offgridevices/mesh-fieldlab/docs/packet-logger-design.md

# Standalone packet logger — design

**Status:** design agreed, implementation starting. Hardware not yet in hand.
**Date:** 2026-08-11

A self-contained field logger that records per-packet RSSI, SNR, hop data and node identity from a Meshtastic mesh to a microSD card, with **no phone and no laptop present at the node**. Data is retrieved afterwards by pulling the card.

Four are being built. They run unattended for a full field session.

---

## 1. What this is

A microSD packet logger for a Meshtastic node. It records the metadata of every packet the node receives — signal strength, signal-to-noise ratio, hop count, sender, packet ID — as CSV, unattended, with no phone or computer attached.

Stock tooling does not cover this. A paired phone displays signal strength live but writes nothing to disk and has to stay within Bluetooth range. The natural alternative — having the radio firmware write the file itself — does not work on this hardware, for reasons worth documenting since the official documentation currently suggests otherwise.

## 2. Why the radio cannot do this alone

Verified directly against `meshtastic/firmware` at commit `546b9d9` (2026-08-11) and `meshtastic/Meshtastic-arduino` at `v0.0.7`. If you are reading this later, re-check — these are the kind of facts that change.

### 2.1 Serial `LOG` mode is documented but not implemented

The Meshtastic docs describe serial mode `LOG` as "ideal for logging mesh activity to a data logger such as a SparkFun OpenLog", and the protobuf enum defines both `LOG = 9` and `LOGTEXT = 10`.

No handler exists. In `src/modules/SerialModule.cpp`, `handleReceived` branches on `PROTO`, `DEFAULT`/`SIMPLE`, `TEXTMSG`, `NMEA`/`CALTOPO`, `WS85` and `MS_CONFIG`. Setting a device to mode 9 or 10 produces no output at all.

**The documentation is ahead of the code.** Anyone planning around `LOG` mode should test it before building on it.

### 2.2 Range Test cannot save to file on nRF52 boards

`RangeTestModule` looks like it solves this — it has a `save` option and writes a CSV including RSSI. But in `src/modules/RangeTestModule.cpp`, the entire body of `appendFile` is wrapped in `#ifdef ARCH_ESP32`. The `#else` branch logs `Can't store range test results - ESP32 only` and returns.

The call site *is* compiled for nRF52, so on a RAK4631 the function is called on every packet and does nothing. `range_test.save` silently has no effect.

Range Test remains useful as a **traffic generator**, and is used that way here.

### 2.3 GPS and a serial logger are mutually exclusive on the RAK19003

On the RAK19003 base board, WisBlock sensor slots C and D carry `TXD1` and `RXD1` — the same UART1 that the `J7` header exposes. A UART GPS module in either slot contends with the serial logger for the same peripheral.

You can have a GPS module or a serial logger, not both. Positions are handled another way (§7).

### 2.4 What does work

`SerialModule` is compiled for nRF52 (the arch guard in `SerialModule.h` includes `ARCH_NRF52`), and `PROTO` mode exposes the full Meshtastic client API over the serial port — the same protocol the phone apps use. That is the path this design takes.

## 3. Architecture

Each node is a Meshtastic radio, a small logger microcontroller pretending to be a phone, and a memory card.

```
   [ RAK4631 + RAK19003 base ]                 [ XIAO ESP32-C6 ]
   stock Meshtastic firmware                   Meshtastic-arduino (forked)
   Serial Module = PROTO                       acts as a client, as a phone would
   whip antenna via U.FL -> SMA pigtail
                                                        |
   J7 pin 2  TX1  ------------------------->  D7 (GPIO17) RX
   J7 pin 1  RX1  <-------------------------  D6 (GPIO16) TX
   J7 pin 3  GND  --------------------------  GND   (signal return)
   J6 pin 1  VDD 3.3V --------------------->  3V3
   J6 pin 2  GND  --------------------------  GND   (power return)
                                                        |
                                                        v
                                            [ 3.3V microSD breakout ]
                                            SCK D8 / MISO D9 / MOSI D10 / CS D3

   P2  <---  one ~2000 mAh LiPo (the only battery in the node)
```

The radio runs unmodified firmware. All custom code lives on the logger board.

### 3.1 The logger must transmit, not just listen

A passive tap on the radio's transmit line does not work. The client has to talk back:

- The radio streams nothing until it receives a `want_config_id` request. Silence in, silence out.
- The library sends a heartbeat every 60 seconds. The firmware comment is explicit — it cannot detect whether a client is attached, so it infers presence from recent messages.

A receive-only wiring goes quiet after about a minute. **Both directions must be connected.**

### 3.2 Alternatives considered and rejected

| Option | Why not |
|---|---|
| Range Test `save` | ESP32-only; these boards are nRF52 (§2.2) |
| Serial `LOG` mode + OpenLog | Not implemented in firmware (§2.1) |
| Phone or laptop at each node | Not possible with nodes kilometres apart and two people |
| Raspberry Pi Zero 2 W | Chronic availability problems |
| Raspberry Pi 5 | Needs 5 V at several amps; will not run from a 3.7 V LiPo |
| XIAO nRF52840 / RP2040 / SAMD21 | Library falls back to software serial — unreliable at 38400 continuous |
| SD module with a level-shifter chip | Its regulator wants 4.5–5.5 V. There is no 5 V rail on a battery node |
| Separate LoRa sniffer per node | Measures the sniffer's link, not the node's |

## 4. The library change

The logger uses [`meshtastic/Meshtastic-arduino`](https://github.com/meshtastic/Meshtastic-arduino), which speaks the client protocol over a wire. It needs one change.

**The library decodes RSSI and SNR and then discards them.** `meshtastic_MeshPacket` carries `rx_rssi` and `rx_snr`; the library's nanopb decode populates both. But all three public callbacks — text message, portnum, encrypted — omit them from their signatures. Neither field is read anywhere in `mt_protocol.cpp`. There is no setting that changes this.

Since RSSI and SNR are the entire measurement, this is not optional.

### 4.1 The change

Add a fourth callback carrying the full packet metadata, fired at the top of `handle_mesh_packet` for **every** packet — before the portnum switch, whose `default:` branch would otherwise drop unrecognised port numbers from the log entirely.

```c
typedef struct {
  uint32_t from, to, id, rx_time;
  uint8_t  channel;
  float    rx_snr;
  int32_t  rx_rssi;
  uint8_t  hop_limit, hop_start, next_hop, relay_node;
  bool     via_mqtt, is_decoded;
  uint32_t portnum;      // valid only when is_decoded
  uint16_t payload_size;
} mt_packet_meta_t;

void set_packet_meta_callback(void (*cb)(const mt_packet_meta_t *meta));
```

Roughly 30 lines across two files. **Existing callback signatures and return values are untouched**, so the library's own examples still compile and future merges stay simple. With no callback registered the added cost is one null check per packet.

**Status: written, and pinned below.** The change also ships an example sketch and a host-side test suite that builds the library against a stub Arduino layer, so the callback can be exercised on a development machine. Twenty-eight checks cover field-by-field propagation, direct versus relayed receptions, encrypted payloads, unrecognised port numbers, and registering and unregistering the callback. Passing them says nothing about real hardware — that is what §12 is for — but it means the first bench session starts from code already known to compile and behave.

### 4.2 Delivered as a fork

The change lives in a **fork of `Meshtastic-arduino` under the `offgridevices` org**, and this repository references it pinned to an exact commit:

```ini
lib_deps = https://github.com/offgridevices/Meshtastic-arduino.git#8f17d8010a916ca1307dc9ae0da31bb4964b17d7
```

This keeps the repository's no-vendored-source rule intact — what is committed here is a reference, not somebody else's code. It also satisfies GPL-3.0's requirement that modified versions carry clear notice of change, structurally: the fork's commit history *is* the notice.

**Pin to a commit, never a branch.** A floating reference means the firmware that produced a given day's measurements can no longer be rebuilt, and reproducibility is most of the reason to work this way.

**Fork base is upstream `master` at `04af41a`**, not the `v0.0.7` tag. The tag predates a substantial May 2025 rework (upstream #42) that restructured packet handling and added the portnum and encrypted callbacks; the change described above builds directly on that structure and would be considerably more awkward against the tag. Most recent upstream source change: January 2026.

The change will be offered upstream once it has proven itself in a real multi-node field run. Upstream does merge outside contributions — the rework above came from a community pull request — so this has a reasonable chance of being accepted rather than living as a fork forever.

## 5. Hardware

### 5.1 Per node

| Item | Notes |
|---|---|
| RAK4631 Core + RAK19003 Mini base | nRF52840 MCU, SX1262 radio. Arduino bootloader, not RUI3 |
| Seeed XIAO ESP32-C6 | Needs Arduino ESP32 core 3.x or newer |
| 3.3 V microSD breakout | Bare socket. Power pin must read **3V3**, not 5 V |
| microSD card | 32 GB or smaller, **FAT32, MBR partition scheme**. On macOS that is Disk Utility → *Show All Devices* → select the **card**, not the volume → Erase → Format `MS-DOS (FAT)`, Scheme `Master Boot Record`. exFAT does not work with the Arduino SD library, and a GUID scheme often fails to mount. The card is left empty; the firmware creates its own file |
| 915 MHz whip antenna | Same model on all four within a run |
| U.FL → SMA pigtail | |
| LiPo ~2000 mAh, JST-PH 2.0 | Protected cell |
| 0.91" 128×32 OLED, SSD1306, I²C | Status display. Four-pin module; must accept 3.3 V |
| SPST slide switch, ≥1 A | Inline on the battery positive lead. Recessed or guarded |
| Momentary push button | Wakes the display. Panel-mounted, beside the switch |
| 100 µF electrolytic × 2, 0.1 µF ceramic × 2 | One pair at the logger, one at the card |
| 10 kΩ × 2 | Contingency only — MISO and CS pull-ups if mounts prove flaky |

### 5.2 Wiring

This table is the contract between the firmware and the board. The carrier
PCB that implements it lives in
[offgridevices/offgrid-hardware](https://github.com/offgridevices/offgrid-hardware/tree/main/packet-logger-carrier);
`tools/tests/test_pinmap.py` checks it against `firmware/src/config.h`, so
changing the wiring means moving all three together. Wiring by hand on
protoboard works from the same table.

| RAK19003 | Signal | XIAO ESP32-C6 | GPIO |
|---|---|---|---|
| J7 pin 2 | TX | **D7** (RX) | 17 |
| J7 pin 1 | RX | **D6** (TX) | 16 |
| J7 pin 3 | GND | GND | — |
| J6 pin 1 | VDD 3.3 V | 3V3 | — |
| J6 pin 2 | GND | GND | — |
| J7 pin 4 | BOOT | **do not connect** | — |

**Wire by the printed label, not by these pin numbers.** RAK changed which UART reaches `J7` between board revisions and did not update the datasheet: Rev B silkscreens `RX1`/`TX1`, Rev D and later silkscreen `RX0`/`TX0`. The positions and the wiring are identical — only the radio's configuration differs, which is §8.

**`J6` carries `VDD`, which is the always-on 3.3 V rail.** The switched rail is `3V3_S`, controlled by `IO2` from the Core module, and it feeds the sensor slots. Powering the logger from `VDD` means the radio's own power management cannot cut it. Worth confirming with a meter on the first board anyway.

The `RAK4630` marking on the Core module is the radio stamp soldered to it; the module as a whole is the `RAK4631`, which is the Meshtastic build to flash, and it needs the **Arduino bootloader, not RUI3**.

| microSD module | XIAO | GPIO |
|---|---|---|
| CLK *(labelled SCK on some modules)* | D8 | 19 |
| MISO | D9 | 20 |
| MOSI | D10 | 18 |
| CS | D3 | 21 |
| 3V3, GND | 3V3, GND | — |

**The module must be 3.3 V native.** Many cheap microSD breakouts carry an `AMS1117` regulator and a `74LVC125` level shifter and expect 5 V, which does not exist anywhere in this build. A module whose only power pin is labelled `3V3` and which has no regulator on it is the right kind.

| OLED (SSD1306) | XIAO | GPIO |
|---|---|---|
| SDA | D4 | 22 |
| SCL *(labelled `SCK` on some modules — it is the I²C clock, not SPI)* | D5 | 23 |
| VCC, GND | 3V3, GND | — |

**Check the power and ground order before wiring.** These modules ship as `GND VCC SCL SDA` and as `VCC GND SCL SDA`, and reversing the first two is the usual way to destroy one.

| Panel control | XIAO | GPIO |
|---|---|---|
| Momentary button, other leg to GND | D0 | 0 |
| Slide switch | *not wired to the logger* — see §5.3 | — |

**The display is on I²C, deliberately.** The C6 has exactly one hardware SPI bus and the card already owns it. Putting the display on a separate two-wire bus means a dead screen, a shorted display wire, or a display library that misbehaves cannot disturb a card write. The card's job is the only one that matters after the node is walked away from.

The button uses the internal pull-up and reads low when pressed; no external resistor.

**Do not use the XIAO's own BOOT button for this.** It is the boot-select strapping pin, so holding it while the power switch is flicked on puts the board into firmware-update mode instead of logging — a silent failure in exactly the situation the switch creates. It is also unreachable once the enclosure is sealed.

Pins after all of the above: **D1 and D2 spare.**

Cross-connect rule: each device's transmit goes to the other's receive. Getting this backwards is the most common cause of "no data".

Cover the BOOT pad with Kapton so a stray strand cannot bridge to it.

**Known quirk:** GPIO16/17 are the C6's boot-log pins. At power-up the ROM bootloader may emit characters into the radio's receive line. Harmless — the protocol framing rejects it — but if it causes instability, any GPIO can be reassigned via `Serial1.begin(baud, SERIAL_8N1, rx, tx)`.

### 5.3 Power

One battery per node, on the radio's `P2` connector. The logger, card and display all run from the radio's 3.3 V rail via `J6`.

**The switch goes in the battery's positive lead, between the cell and `P2`** — not anywhere on the logger. It cuts power to the whole node at once, which is the point: everything stops together and the log simply ends.

Three consequences worth knowing before the first field day:

- **USB overrides it.** Plugging USB into the radio powers the node whether the switch is on or off. On the bench you will forget this and conclude the switch is broken.
- **Charging needs the switch on.** With it off, the radio's charger is disconnected from the cell.
- **Power-cycling is a normal operation, not a fault.** Each boot opens a new file stamped with the date and time it started, so nothing is ever overwritten, no session is lost by turning a node off and on, and no single file grows without bound. Switch a node off on Tuesday and on again on Thursday and you get two files that say so on the outside.

Why single-supply beats a split one: only one connector ever sees a battery, so the polarity check happens once; and if power fails, everything stops together and the log simply ends — rather than the logger dying silently while the radio keeps transmitting.

The budget this was designed to, before anything was built:

| Device | Average | Peak |
|---|---|---|
| RAK4631 + base, mostly receiving | 20–35 mA | 130 mA transmit, ~1 s bursts |
| XIAO at 80 MHz, radios off | 20–35 mA | — |
| SD module, one write per 2 s | 5–15 mA | 30–100 mA, few-ms bursts |
| OLED, blanked after boot | <0.1 mA | 5–8 mA while displaying |
| **Total** | **design to 80 mA** | ~275 mA worst case |

The display is the one part that is switched off in software rather than left running. It is lit for the thirty-second boot test and for ten seconds per button press; the rest of the session it is asleep and draws microamps. Left permanently lit it would add roughly a tenth to the node's total draw for information nobody is standing there to read.

The base board's 3.3 V rail is rated 750 mA, so worst case is about a third of budget.

**Measured on unit one, 17 August 2026** — complete node, radio and logger and card and screen, bench supply at 3.9 V, receiving real mesh traffic with the screen blanked:

| | Measured |
|---|---|
| Idle, receiving, screen blanked | **39 mA** |
| Transmit bursts | ~139 mA |
| Highest seen | 169 mA |

**The node draws less than half the budget it was designed to**, which changes the battery and therefore the box. Twelve hours — an eight-hour session with the 1.5× margin §12 insists on — is about 470 mAh at this draw, call it 700 mAh once derated for real capacity and cutoff voltage. **A 1000 mAh cell covers a full field day.** The 2000 mAh cell originally specified runs roughly **thirty hours**, not the seventeen estimated above; the estimate was pessimistic about average draw, not about capacity. The enclosure can be smaller than planned.

**The peak figure is not yet trustworthy.** 169 mA was measured against a supply limited to 200 mA, and a limiter suppresses the very transmit burst the number is meant to capture — you cannot measure a peak your supply is clipping. The 39 mA average is sound; the peak must be taken again at a 500 mA limit. Two numbers are still owed here, both in ladder step 11: the true peak, and idle draw with the screen lit rather than blanked, so the cost of the display is a measurement instead of the estimate in the table above.

### 5.4 Safety

- Battery voltage must not exceed **4.3 V** — base board absolute maximum.
- **The RAK19003 battery connector is reverse-polarity versus the common hobby JST-PH pinout.** Confirm with a meter before every first connection. Label every battery.
- **Adding the switch means cutting a battery lead**, which is a fresh opportunity to get that polarity wrong on a connector that is already backwards. Cut and splice one lead at a time so the two are never both open, keep the switch in the positive leg, sleeve the joint, and meter the connector again afterwards. Never cut both leads at once — a LiPo with two bare ends is a short waiting for a workbench.
- First power-up on a **current-limited bench supply**, never a LiPo. Set 3.9 V, 200 mA limit; expect 20–60 mA — a complete node measured 39 mA. Pinned at the limit means a short; near zero means an open or reversed connection.
- **A bench supply on `P2` is a fine substitute for the cell on the bench**, and is the better way to work up to the first field day. Stay inside the battery range — **3.8–4.0 V**, never above the 4.3 V absolute maximum, and not as low as 3.3 V or the regulator drops out under load. Raise the limit to **500 mA once the radio transmits**, because 130 mA bursts against a 200 mA limit brown the node out and read as random resets. Raise it before **measuring** anything, too: a limiter clips the burst it is asked to report, so a peak read at a 200 mA setting is the limiter's number rather than the node's (§5.3).
- **Never run USB and a bench supply at the same time.** The base board charges a cell from USB, and with a supply on `P2` the charger pushes current into a source that cannot absorb it. USB alone for flashing and configuring; supply alone for powering.
- **Confirm `J6` reads 3.3 V with a meter before connecting anything downstream.** One probe, and it is the difference between a working node and three dead modules.
- **Never plug USB into the logger board while it is being fed 3.3 V from the radio.** One source at a time. Charging via the radio's USB is fine.
- **Never power the radio with no antenna attached.** Transmit power reflects into the amplifier, and the measurement is invalid anyway.

### 5.5 Mounting

**The binding dimension is 30 mm.** The base board is 30 mm wide. On a 50 mm-wide proto board that leaves room for exactly one more module beside it, and only if that module is the narrow one. That single fact chooses the board, its orientation, and therefore every opening in the enclosure.

Of the proto board sizes to hand, **7 × 5 cm turned landscape is the smallest that works**:

| Board | Verdict | Why |
|---|---|---|
| **7 × 5 cm** | **Use this** | Radio and logger sit side by side along the 70 mm edge with 22 mm to spare, and the card still has a clear 20 × 18 mm below. About half the board ends up unused, which is what makes it solderable rather than a fight |
| 6 × 4 cm | Possible | Everything lands, with roughly 1 mm to spare under the card module and nowhere at all for the decoupling parts. Saves 10 mm of box length |
| 7 × 3 cm | No | The board is exactly as wide as the radio. No margin, and the logger and card have nowhere to go but on top of each other |
| 8 × 2 cm | No | Narrower than the radio |
| 9 × 7 cm | Wasteful | Fits easily, and costs 20 mm of box length for nothing |

Layout, on the 2.54 mm grid, seen from the component side:

```
                              70 mm
    +----------------------------------------------------+
    |    [USB-C]                          [USB-C]        |  <- port wall
    |   +-----------------+  :  :      +-------------+   |
    |   |    RAK19003     |  :  :      |    XIAO     |   |
    |   |   + RAK4631     |  :  :      |  ESP32-C6   |   |
    |   |     30 x 35     |  :  :      |  21 x 17.8  |   |
    |   |  J6         J7  |  :  :      +-------------+   |  50 mm
    |   +-----------------+  :  :                        |
    |  = = = = = = = = = = = : =: = = = = = = = = = = =  |  3V3 rail  \ solder
    |  = = = = = = = = = = = : =: = = = = = = = = = = =  |  GND rail  / side
    |                        :  :      +-------------+   |
    |   [ 6-way lead pads ]  :  :      |   microSD   |   |
    |                        :  :      |   20 x 18   |   |
    |                        :  :      +----[====]---+   |
    +----------------------------------------------------+
                          13 mm channel      ^ card slot
```

- **Both USB-C ports face the same wall.** This is the only arrangement that achieves it on a 50 mm-wide board, and it is worth the effort: the enclosure then needs one bench face and one field face rather than openings scattered around it.
- **The card sits directly under the logger**, which keeps its bus 20 mm long. It is the only fast bus on the board and the only one worth optimising; everything else is slow enough not to care.
- **Power and ground run on the solder side**, as two bare wire rails across the middle of the board. Every module drops through to them rather than routing around them, which is what keeps the component side almost free of crossings. The rails pass under the radio, using space that is dead anyway.
- **A 13 mm channel** between the radio and the logger carries the serial pair, the screen pair and the button. It is the only part of the board with nothing above it, which later decides where two of the lid components can sit (§5.6).
- **Only four things are on the board**: radio, logger, card module and the decoupling parts. The screen, the button, the switch and the antenna are all panel-mounted and reach the board on flying leads.
- **The screen and button leave as one 6-way connector.** With the antenna lead unplugged that is two disconnects between a closed box and a bare board, which is what makes the lid removable rather than merely detachable.

Module footprints, from the manufacturers' own drawings:

| Part | Footprint | Mounting |
|---|---|---|
| RAK19003 + RAK4631 | 30 × 35 mm | Two 4-pin 2.54 mm headers, `J6` and `J7`, both on one edge |
| Seeed XIAO ESP32-C6 | 21 × 17.8 mm | 2 × 7 pins, rows 0.6 in apart, both on the 0.1 in grid |
| 3.3 V microSD breakout | ≈ 20 × 18 mm | 1 × 6 pins on the edge opposite the card slot |
| 0.91 in OLED, 128 × 32 | 38 × 12 mm, active area 22.4 × 5.6 mm | 4 pins; panel-mounted, not on the board |

**Two numbers to take off the real parts before committing to anything.**

- **The distance between `J6` and `J7`.** If it is a whole number of holes the radio drops straight into the board. If it is not, the radio still sits where the layout puts it but goes down on standoffs with five short wires instead of two header strips. The layout does not change either way; the assembly method does.
- **The height of the assembled radio stack.** It is the tallest thing in the node and therefore the only thing that sets the lid. Measure from the board face to the top of the antenna connector once the core is seated.

### 5.6 The enclosure

Sized off the layout above, with 3 mm of clearance around the board and the cell underneath it:

| | |
|---|---|
| Internal cavity | 76 × 56 × 32 mm |
| Box, closed | 80 × 60 × 37 mm — walls 2, floor and lid 2.5 |
| Standing on its feet | 41 mm to the top of the lid |
| With the antenna on | ≈ 140 mm overall |

**Each face does one job.** Ports on one long wall, card on the other, switch on a short wall, and the three things you look at or touch in the field on the lid. **The floor has no opening of any kind**, which is what makes the node safe to stand on damp ground.

| Face | Carries | Opening |
|---|---|---|
| Long wall A | Both USB-C ports | Two wells 14 × 8 mm, centres 38 mm apart, 23.3 mm above the floor |
| Long wall B | microSD card | Slot 18 × 8 mm with a finger scallop below it |
| Short wall A | Power switch | Pocket 22 × 14 mm recessed 3 mm; slot sized to the switch |
| Short wall B | — | Nothing. Leave it solid |
| Lid | Screen, button, antenna | Window 26 × 9 mm, hole Ø12 mm, hole Ø6.5 mm |
| Floor | Feet | None |

**Two lid positions are forced rather than chosen**, and both by what is underneath them:

- **The antenna cannot go over the radio.** There is about 4 mm of air above the radio stack and a bulkhead connector needs roughly 15 mm behind the panel. It goes over the flying-lead area instead, which has the full cavity height above it.
- **The button cannot go under the screen.** A panel button is about 10 mm deep and the gap above the card module is 10.4. It goes over the 13 mm channel, which is the only part of the lid with real room behind it.

**Water.** The lid overlaps the body so rain runs down the outside rather than into the seam, a small ledge above each port well sheds water off it, the feet lift every seam clear of standing water, and the floor is unbroken. Two printed bungs close the port wells when no cable is in them. This is **damp grass proof, not rain proof** — it is a field prototype, not an IP-rated box.

**Standing it up.** The node is meant to be **set down on the ground with the antenna vertical**. The log sheet wants height above ground recorded (§7); on the ground that number is about 40 mm, which is as valid an entry as any other. What the measurement actually depends on is that **the answer is identical on all four nodes**, since the comparison is between links within the set. The one thing to avoid is grass taller than the box, which puts the antenna inside the vegetation rather than above it and varies between sessions for no reason anybody records.

A **¼-20 threaded insert** in the floor is optional, and only worth fitting if ground level ever proves too noisy to work with. It has one consequence worth knowing before printing: the cell lies flat on the inside of the floor and covers nearly all of it, so the boss that holds the insert has to hang **below** the floor rather than rise inside it, and the feet must then grow from 4 mm to 7 so the box stands on its feet rather than on the insert. That costs 3 mm of box height. The hole is blind, stopping 2 mm short of breaking through, so the floor stays as sealed as it was.

**Printing.**

- **Print the body upside down**, floor upward. The floor is the face that has to stay watertight, and printing it as a top surface rather than as the first layer is the difference between a sealed floor and a floor with a seam in it. Supports are needed only inside the switch pocket.
- **Cut the openings last.** All three wall openings are positioned off the board stack, and the stack height depends on how the modules are mounted — plain headers put the ports at 23.3 mm above the floor, short wire links on 3 mm standoffs put them nearer 15, and in the second case the two ports no longer sit at the same height as each other. Build the board, measure where the three openings actually land, then commit the walls. Modelling the port wall as a **separate 80 × 34.5 mm plate that screws into a rebate** makes a wrong guess cost one small part rather than the whole box.
- **The headers set the box height, not the parts.** 8.5 mm of the 32 mm cavity is pin-header plastic. Direct wire links on 3 mm standoffs bring the cavity to about 26 mm and the closed box to 31, at the cost of a radio that no longer unplugs.

## 6. File format

One file per node per power cycle: `/LOG_<SHORTNAME>_<YYYYMMDD>_<HHMM>.csv`

The stamp is the node's **local** time at the moment logging started — a person holding a box of cards wants to recognise the afternoon they collected them, and no file can grow without bound because switching a node off ends it. Two boots inside the same minute, which is how a brownout loop looks, break the collision with a trailing `-2`, `-3`.

**Every timestamp inside the rows stays UTC.** People get local time on the outside of the file; machines get UTC on the inside, so no analysis ever has to reason about which side of a daylight-saving change a session landed on. The `BOOT` row records `tz` and `utcoff`, which is what lets the local-time name be turned back into UTC without anyone remembering which week the clocks changed.

**Nothing is logged until the clock is set.** The boot holds after the self-test and waits for the time, showing on screen what it is waiting for, because a file that starts before the clock cannot be lined up against the other three and the rows written in that window would be the only ones in the session with no absolute time on them. See §9.2.

**The wait is bounded, not absolute.** If the time never arrives the node logs anyway, under `/LOG_<SHORTNAME>_<BOOTCOUNT>.csv`, and the `BOOT` row records how long it waited in `clkwait`. An undated file still holds every RSSI and SNR reading and every link statistic within itself; coming home with nothing because a phone would not pair is not a trade worth making. If the clock turns up later the file is renamed in place. A boot-counter name surviving in a delivered set therefore means one specific thing: **that node waited, gave up, and never learned the time all session.** `validate-csv` reports this as `FILENAME_NO_CLOCK` rather than leaving it to be noticed.

Where the time comes from at all is §8.

```
schema_ver,uptime_ms,dev_rx_time,rx_node,tx_node,to_node,pkt_id,rx_rssi_dbm,
rx_snr_db,hop_limit,hop_start,hops_used,relay_node,next_hop,via_mqtt,portnum,
decoded,payload_size,channel,row_type,extra
```

`tools/src/fieldlab/schema.py` is the machine-readable version of this section, and `validate-csv --schema` prints the exact header the firmware must write.

| Field | Meaning |
|---|---|
| `schema_ver` | **4.** Bump on any change. v3 files stay readable — the header decides which layout a file is read under, and both are still understood |
| `uptime_ms` | Milliseconds since boot — the authoritative relative clock |
| `dev_rx_time` | Device epoch seconds — absolute clock, `0` if never set |
| `rx_node` | The logging node. Constant for the whole file |
| `tx_node` | Packet originator on `PKT` rows; the node being described on `NODE` rows |
| `to_node` | **v4.** Destination. `4294967295` is broadcast, which is what Range Test sends; a directed packet and a broadcast cost the channel differently |
| `pkt_id` | Dedupe key for flood copies |
| `rx_rssi_dbm` | Negative; closer to zero is stronger. **`0` means locally originated — filter out** |
| `rx_snr_db` | LoRa decodes to roughly −20 dB |
| `hop_limit` / `hop_start` | Remaining hops, and hops the packet started with |
| `hops_used` | Computed as `hop_start - hop_limit`. **`0` means direct reception** |
| `relay_node` / `next_hop` | Single bytes — the *last byte* of a node number, not a whole one. Routing hints, `0` if none |
| `via_mqtt` | Must be `0`; anything else means an internet gateway is polluting the data |
| `decoded` | **v4.** `1` if the payload could be decrypted. `portnum` means nothing when this is `0` — and `0` is also a legitimate portnum, so before this column the two cases were not separable |
| `portnum`, `payload_size`, `channel` | Application port, byte count, channel index |
| `row_type` | `PKT` \| `STATUS` \| `NODE` \| `BOOT` |
| `extra` | Empty on `PKT` rows. Everything a non-packet row needs to say, as `key=value` pairs joined by `;` |

### 6.1 Non-packet rows

Four kinds of row share one set of columns, because one open file on a microSD card is far more robust on an unattended node than four. The packet columns are fixed and typed; anything a `BOOT`, `STATUS` or `NODE` row needs beyond them goes in `extra`. Packet columns are written as `0` on those rows, so a reader filtering by `row_type` never has to wonder whether a value is real.

Values may not contain a comma or a semicolon. That keeps the field unquoted and readable by any CSV parser, and a stray separator is reported as an error rather than silently truncating a value.

| Row | Written | Required in `extra` |
|---|---|---|
| `BOOT` | Once at startup | `fw`, `preset`, `boot`, `lat`, `lon`, `alt`, `ant` |
| `BOOT` also carries | **v4**, required | `usepreset`, `txpwr`, `bw`, `sf`, `cr`, `chan`, `txon` — what the preset name actually stands for. A preset is only binding while `usepreset` is `1`; with it `0` the radio is on the explicit `bw`/`sf`/`cr` and the name it still reports is a leftover. `txpwr` is never implied by a preset at all, and every RSSI reading in the file is relative to it |
| `BOOT` also carries | optionally | `st_card`, `st_write`, `st_radio`, `st_pos`, `st_clock`, `st_heard`, `batt`, `disp` — what the boot self-test (§9.1) found |
| `BOOT` also carries | on a resumed file | `resume` — seconds of session already elapsed when this file was opened, because the card arrived late or was swapped (§9.4) |
| `STATUS` | Every 60 s | `rows`, `sd_ok`, `heap` |
| `STATUS` also carries | optionally | `drops` — rows formed with nowhere to write them; `recov` — the blocks that just came back, joined with `+` (§9.4) |
| `NODE` | Every 300 s, one row per known node | `name`, `lat`, `lon`, `batt`, `last_heard` |
| `NODE` also carries | **v4**, required | `chan_util`, `air_tx`, `volt`, `pos_time` — see §6.3 |
| `NODE` also carries | optionally | `snr`, `hops`, `up` — reserved. The library drops these before user code reaches them, so writing them needs a change to the pinned fork; reserving them now means that change will not need a v5 |

Adding an **optional** key does not bump the schema version: a reader that does not know it emits a warning and carries on, and every old file stays valid. Adding a column, changing a range, or adding a *required* key does.

**A reading the radio did not supply is written as an empty value**, never as a zero — `chan_util=` rather than `chan_util=0`. A channel genuinely at 0% and a radio that did not answer are different facts, and a session that quietly averaged the second into the first would report a quiet channel it never measured. The firmware writes empty wherever the library hands back NaN, which is what a node report with no device-metrics block produces — ordinary for a neighbour heard once in passing.

### 6.3 What the `NODE` row measures

`chan_util` is the reason these rows are worth their space.

Signal strength answers whether a link exists. It cannot answer what the link *cost*, because a channel that is idle and a channel that is saturated produce identical RSSI. `chan_util` is the radio's own estimate of the fraction of wall-clock time the channel was busy — including every other transmitter on the frequency, which no record of our own traffic could ever see. `air_tx` is this node's own share of the last hour.

Two things follow for anyone reading a session:

- **Utilisation is a property of a place, not of a node.** It is recorded against the node that *reported* it. The rows a node writes about its neighbours repeat what those neighbours last advertised, which is a different measurement taken somewhere else, and counting them would average away exactly the differences between positions that the session exists to find.
- **Above roughly a quarter of the channel the measurement changes meaning.** Meshtastic holds back non-critical traffic once utilisation is high, so past that point a session measures the radio's own governor rather than the path. `analyze-logs` warns when peak utilisation crosses 25%.

`volt` is a truer battery state than the percentage beside it, and `pos_time` is when the coordinate on the row was actually fixed — a stale position and a fresh one are otherwise the same six decimal places.

### 6.2 The checker

**This format is the contract between the logger and the analysis tooling**, so its checker was written before the firmware. `validate-csv` separates two kinds of problem.

An **error** means the file cannot be trusted: a wrong header, an impossible value, a hop count that contradicts itself, a node apparently receiving its own transmission, packets that arrived over MQTT rather than the air, a fixed position left at 0,0. Analysing a file with errors produces numbers that look reasonable and mean nothing.

A **warning** means the file is readable but something is worth knowing: a truncated last row where the node lost power mid-write, a gap where the status heartbeat stopped, a link with too few packets to take a median from.

The checker also re-reports whatever the boot self-test found, so a file can be judged weeks later without anyone having to remember what the screen said in the field.

Run it on the card before leaving the site:

```bash
uv run validate-csv /Volumes/LOGGER/ --min-packets 100
```

`synth-log` writes schema-valid files with invented numbers, so the analysis tooling can be built and tested before there is hardware to record anything real.

## 7. Position and time without GPS

A GPS module cannot coexist with the logger (§2.3), and is not needed.

**Position is set from a phone, on site, at the moment the node is placed.** Everything else about a node is configured once on a bench and never touched again; position is the one setting that cannot be, because it is not known until somebody is standing where the node will sit. Requiring a laptop for it would mean carrying one to every drop point.

So the deployment step is: connect the Meshtastic app over Bluetooth, open the position settings, **enter the coordinate and switch fixed position on**, disconnect, walk away. The logger reads the result back off the radio and shows it, which is what makes the phone enough.

```bash
# The same thing over USB, for a bench node or to check what the phone wrote.
meshtastic --port <PORT> --setlat <LAT> --setlon <LON> --setalt <ALT> \
  --set position.fixed_position true
```

**`fixed_position` does not create a coordinate. It freezes the one the node already has.** A node that has never held a position has nothing to freeze, so the switch does nothing at all — while the app shows it on, which is the trap. The order is therefore not optional:

1. **Fixed position OFF.** A node that already considers itself fixed may ignore what the phone sends it.
2. **Let the phone share its location with the node,** and wait for a send to actually happen. The share interval is a setting; shortening it to fifteen seconds is worth doing before a deployment day, because the default leaves somebody standing in a field waiting for a minute with no indication of why.
3. **Confirm the node now holds a position** — it appears on the app's map.
4. **Fixed position ON.** This is the step that makes it permanent, and it can only work now.
5. **Confirm on the logger's screen** that the position block is filled before walking away.

Step 5 is the one that matters, because it is the only check that reads the radio rather than the phone. A node with the flag set and no coordinate behind it joins the mesh, relays traffic, looks entirely healthy from the app, and records a whole session of rows that can never be tied to a place. The logger therefore treats position as set only when a coordinate is actually there (§9.1) — the flag alone is not evidence, and was believed for most of one bench session precisely because it looks like it is.

Record the intended position as well as the one actually used — the difference between them matters when interpreting the results.

**Position flags** control which fields ride along in a transmitted position. Most of them — satellites in view, heading, speed, dilution of precision, geoidal separation — come from a GPS receiver, and there is none here, so they carry nothing. Altitude is the one that earns its place. Whatever is chosen, **set all four nodes identically**: the cost of a stray flag is not airtime, it is another axis on which one node can quietly differ from the other three.

**Altitude.** Do not take altitude from GPS. Consumer GPS vertical accuracy is ±10–20 m, roughly twice as bad as horizontal. Instead:

```
node altitude = ground elevation at (lat, lon) from a 1 m DEM
              + height above ground, measured with a tape
```

Both terms are more accurate than any GPS module you could attach. This makes **measured height above ground a required field** on the field log sheet.

**Time.** The logger has no clock of its own. The XIAO has no battery-backed RTC, so every cold boot starts knowing nothing, and the only automatic source of real time is the radio — which stamps received packets with `rx_time`, and only knows the time itself if something told it.

That makes the chain worth stating plainly, because every link can break:

| Step | What supplies it | What happens if it is missing |
|---|---|---|
| Something knows the time | A GPS on any node, or a laptop running the Meshtastic CLI | **Nothing on the mesh has a clock, ever** |
| The radio learns it | CLI on connect, or another node propagating it over the mesh | That node's rows have `dev_rx_time = 0` |
| The logger learns it | `rx_time` on the first packet it receives | The file keeps its boot-counter name |

The practical consequence: **a full power-down loses the time.** The nRF52840 in the radio has no battery-backed clock either, so a node switched off on Tuesday and switched on again on Thursday starts with no idea what day it is, and stays that way until a packet arrives from something that does know.

Two ways to close that, and they are not equivalent:

- **Give one node a GPS.** It reacquires time by itself on every power-up and seeds the whole mesh. This is the only option that survives an unattended power cycle in a field with no laptop present, which is exactly the workflow the logger is built for.
- **Push the clock from the CLI before each deployment.** Connecting all four nodes to one laptop in one session gives every node correct absolute time and costs nothing extra. It has to be redone after every full power-down.

Until one of those happens the logger still records everything — `uptime_ms` is unaffected, RSSI and SNR are unaffected, and per-link statistics within a single file are unaffected. What is lost is the ability to line one node's file up against another's, and the ability to date the file.

This is **unverified** and must be tested on the bench. If it does not hold, fall back to `uptime_ms` plus a manually recorded start time — sufficient here, because the analysis computes session medians rather than time-of-flight.

## 8. Radio configuration

Identical on all four nodes except name and position.

### 8.1 The firmware version, pinned

**All four radios run Meshtastic `v2.7.26` (`54e0d8d`), the `rak4631` build with the Arduino bootloader.**

The version is pinned for the same reason the library and the build platform are: a run has to be able to be repeated on the same instrument. Different firmware between nodes is one of those faults that produces perfectly plausible data nobody can legitimately compare, and produces it silently — there is no error, only four sets of numbers that were never measured the same way.

Do not assume the version in the box is the version you want. Unit one arrived running **2.6.11, and running a vendor variant image** (`rak4631_nomadstar_meteor_pro`) rather than the vanilla `rak4631` build. It joined the mesh, relayed traffic and looked entirely normal. Flash all four to the pinned image rather than trusting what shipped.

Three things about the flashing itself:

- **The UF2 must match the board.** The RAK4631 is an nRF52840; the RAK11310 is an RP2040 — a different processor on a similarly named WisBlock core, listed beside it on the same download page. A mismatched UF2 is not refused loudly. The bootloader silently declines it and **leaves the file sitting on the mass-storage volume**, which looks exactly like a drag-and-drop that did not take, and invites people to try again with the same wrong file. Check the filename says `rak4631` before copying it — and better, check the image rather than its name. The filename is a label; the family ID inside every block is what the bootloader actually matches on. `firmware/radio/check_uf2.py` reads it: a RAK4631 image reports `0xADA52840` and loads at `0x00026000`, a RAK11310 image reports `0xE48BFF56` and loads at `0x10000000`.
- **There is more than one image called `rak4631`.** The nrf52840 release zip contains four: the plain build, `_eink`, `_eth_gw` and `_nomadstar_meteor_pro`. Only the plain one is pinned, and a variant flashes and boots perfectly, so nothing afterwards will tell you which one went on. The cache in `firmware/radio/` holds the pinned image and nothing else, so there is nothing to pick wrongly from.
- **If the board is labelled `RAK4631-R` it ships with RUI3**, not the Arduino bootloader, and must be converted first. The Meshtastic starter kits ship with the Arduino bootloader already.
- **Let the node generate a fresh key.** Meshtastic advisory [GHSA-gq7v-jr8c-mfr7](https://github.com/meshtastic/firmware/security/advisories/GHSA-gq7v-jr8c-mfr7): some vendors built device images by flashing one unit, letting it generate its keys at first boot, and cloning that image across a production batch — shipping identical X25519 keypairs on whole batches of hardware. 2.6.11 onwards warns when it recognises a compromised key, and defers key generation until the LoRa region is first set. This cannot affect the measurements, because broadcast traffic on a shared channel is protected by the channel PSK rather than by per-node keys; it matters because a node holding a cloned key can be impersonated by anyone else holding the same batch image.

### 8.2 The settings

```bash
meshtastic --port <PORT> \
  --set serial.enabled true \
  --set serial.mode PROTO \
  --set serial.txd 20 --set serial.rxd 19 \
  --set serial.baud BAUD_38400 \
  --set position.gps_mode NOT_PRESENT \
  --set lora.region US --set lora.modem_preset LONG_FAST \
  --set device.role CLIENT --set lora.hop_limit 3
```

Notes that will cost you an afternoon if missed:

- **Baud must be set explicitly on both sides.** The firmware default is 38400; the Arduino library's own default is 9600. A mismatch produces silent garbage.
- `override_console_serial_port` is valid **only** with NMEA and CALTOPO. With PROTO it produces a config error and the module will not start. Leave it false.
- `NOT_PRESENT` matters because the same UART routes to sensor slots C and D.
- **The pin numbers depend on the base board revision, and the revision is printed on the board.** RAK moved the UART that reaches `J7` at Rev D: Rev B exposes UART1 there, Rev D and later expose UART0. The wiring is identical; only these two numbers change.

  | RAK19003 revision | `J7` silkscreen | `serial.rxd` | `serial.txd` |
  |---|---|---|---|
  | Rev B | `RX1` / `TX1` | 15 | 16 |
  | **Rev D, Rev E** | `RX0` / `TX0` | **19** | **20** |

  The command above is set for **Rev E**. This was previously an open item to be resolved by trial; it is resolved by reading the silkscreen. Confirmed against the RAKwireless forum thread on the Rev E schematic change, Meshtastic issue #2267, and Meshtastic's own serial-module documentation, which gives 20/19 for "RAK19003 v2 variants" and 16/15 for the RAK19007.
- Keep the modem preset identical across all nodes and all runs. Changing spreading factor mid-experiment invalidates every comparison.

### 8.3 Two ways the tool reports failure on something that worked

Both of these were hit while configuring unit one, and one of them produced a wrong conclusion that survived several minutes and a repeated write. `configure_node.py` has to avoid both; anybody configuring a node by hand needs to know them.

**Setting a value and reading it back in the same invocation crashes the tool.** A command of the form `meshtastic --set-owner N1 --info` applies the change and then aborts *while printing the result*, with `Object of type bytes is not JSON serializable`. The exit status is non-zero and no configuration is printed, so it reads as a write that failed. It did not fail — the setting is on the radio. This is the worse of the two traps, because the natural response to an apparent failure is to run the command again. **Set and read in separate invocations, always.**

**An immediate readback returns the old value.** The write is applied and echoed back asynchronously, so an `--info` run seconds later can still report the previous setting. Reading twice does not help; it returns the stale value twice, which is convincing. On unit one a rename that had worked the first time was declared broken on exactly this evidence and repeated unnecessarily.

The rule that covers both: **a configuration step is not verified until a fresh, separate connection reports the new value.** Not the same command, not immediately, not the value the tool echoed as it wrote — a new connection, afterwards. Everything §12 says about reading configuration back depends on this being done properly, because a readback nobody trusts is no better than no readback at all.

### 8.4 Keeping the record

Save `meshtastic --info` for every node alongside the logs. Config drift between nodes is the most common invisible way to ruin a test.

**Redact it first.** `--info` prints the node's PKI **private key** in its `security` block, and its fixed position with it. A private key in a public repository lets anyone impersonate that node on the mesh, and publishing one cannot be undone — a rotation on every affected node is the only remedy. Strip the `security` block and commit the result as `config/<node>.redacted.json`; `.gitignore` is set so the raw dump cannot be added by accident. This is what `configure_node.py` will write, so the redaction is not left to whoever is holding the laptop that day.

### 8.5 Keeping a test mesh to itself

A controlled test of a fixed set of nodes — two endpoints too far apart to reach each other, two more placed between them to bridge the gap — only measures what it claims to if the set is actually closed. Every node outside the set that joins in is a change to the topology, made by somebody else, that the data records only ambiguously.

**A private channel does not close the set.** This is the trap, and it is worth stating plainly because the setting is named in a way that invites the opposite conclusion. Meshtastic separates the *radio mesh* — everyone sharing a frequency, bandwidth and spreading factor — from *channels*, which are a name and an encryption key layered on top. The channel decides who can **read** a packet. It does not decide who **hears** it, and it does not decide who **relays** it. From the project's own documentation: nodes *"rebroadcast all packets if they share LoRa modem settings, irrespective of encryption"*, and *"all nodes in the radio mesh receive messages."*

So a fresh 256-bit key buys payload privacy and nothing else. Strangers still hear every packet, still rebroadcast them, and still appear in this logger's files — correctly, because their signal readings are real measurements. For a controlled run the relaying is the damaging part: a stranger carrying one of your packets extends your topology by a node you did not place, cannot locate, and may not see again.

**What closes the set is the frequency slot.** Two nodes on different slots are on different frequencies and cannot hear each other at all. The relevant firmware arithmetic, for the US region at a 250 kHz bandwidth:

```
numChannels = floor((freqEnd - freqStart) / (spacing + bandwidth))
            = floor((928.0 - 902.0) / 0.25)                 = 104 slots

freq        = freqStart + bandwidth/2 + (slot - 1) x bandwidth
            = 902.125 MHz + 0.25 x (slot - 1)
```

`lora.channel_num` selects the slot, numbered 1 to 104, and is the setting that matters. Left at its default of `0` the radio falls back to hashing the **primary channel's name** to pick a slot — which is why changing a channel name silently moves a node to a different frequency, and why two nodes with different channel names may not reach each other however carefully their keys match. Set the slot explicitly and the name becomes cosmetic.

The public default, `LongFast`, hashes to **slot 20 — 906.875 MHz**, and that is where essentially all local traffic sits. Any slot well away from it is a candidate; the arithmetic above converts a slot number to the frequency it will actually transmit on, which is the number to check against local band use before committing to it.

**Settings, in addition to §8.2, applied identically to every node in the set:**

| Setting | Value | What it does |
|---|---|---|
| `lora.channel_num` | a chosen slot, **not** 0 | Puts the set on its own frequency. This is the one that provides isolation |
| primary channel PSK | `random`, then shared to the others | Payload privacy. Does **not** isolate — set it because there is no reason not to, not because it does the job above |
| primary channel name | anything, matched across the set | Cosmetic once the slot is explicit, but keep it consistent so nobody is misled |
| `device.rebroadcast_mode` | `LOCAL_ONLY` | Stops **our** nodes carrying foreign traffic. It cannot stop foreign nodes carrying ours — only the slot does that |
| `lora.hop_limit` | `3` | Permits up to three relays. A two-relay bridge needs two, so this leaves one spare. Identical everywhere, or hop counts are not comparable |

`lora.ignore_incoming` looks like it belongs on this list and does not: it is a blocklist of specific node numbers, capped at three entries, and deprecated in the client apps. It cannot express "everyone except these four."

**Proving a slot is empty is a job for this logger.** Set one node to the candidate slot, leave it running for half an hour, and read the card. A file containing nothing but this node's own status rows is the evidence that the slot is clear; any foreign node in it means picking another. This is a better test than reasoning about which slots ought to be busy, and it costs one session.

**Two consequences to expect, neither of them faults.** A node brought up alone on a private slot will report `ALONE` at the end of its self-test until a second node transmits, because there is genuinely nothing else there. And the boot clock wait has no mesh to take a time from, so bring the set up together, or hand a time to one node from a phone and let it propagate.

**Interference is a separate experiment, not a contaminant in this one.** Measuring how the set behaves amid uncontrolled traffic is a real question and a different one. It is answered by re-running the same physical layout on the public slot and comparing against the isolated baseline — which requires the baseline to exist first, and to be clean. Uncontrolled traffic mixed into the controlled run yields neither number.

## 9. Firmware behaviour

```
setup()
  init display; if it does not answer, carry on regardless — see below
  read and increment boot counter in NVS
  run the boot self-test (§9.1), showing each result as it lands
  if the clock is not set, hold and wait for it (§9.2), up to CLOCK_WAIT_MS
  open /LOG_<SHORTNAME>_<YYYYMMDD>_<HHMM>.csv, write header and BOOT row
    (or /LOG_<SHORTNAME>_<BOOTCOUNT>.csv if the wait timed out, renamed later)
  init serial to the radio at 38400, register the packet-metadata callback
  request node report

loop()
  service the protocol (handles want_config and the 60 s heartbeat)
  on each packet: append one row, compute hops_used, increment counters
  flush every 5 s or 10 rows, whichever comes first
  re-attempt whatever is currently broken (§9.4)
  every 60 s: STATUS row
  every 300 s: refresh node report
  on button press: wake the display 10 s, or step one page deeper (§9.3)
  LED: slow blink healthy | double-blink packet logged recently | fast continuous SD failure
```

### 9.1 The boot self-test

The node is switched on, watched for half a minute, and walked away from. That half minute is the only chance to notice a problem before it costs a session, so the test answers the questions that are expensive to get wrong — not merely "did it start".

Each line appears as its check completes, so a hang is visible at the step that hung.

| Check | What it proves | Failure means |
|---|---|---|
| Card mounts | The socket and wiring work | Reseat the card |
| **A row is written, flushed, and read back** | The card actually accepts data | A card that mounts but cannot write is the worst failure mode there is — it looks healthy for hours |
| Free space, and hours it will hold | The session fits | Swap the card |
| Radio answers on the serial link | Wiring, baud rate and PROTO mode are all correct at once | See §8; this is the single most common setup failure |
| Region, preset, hop limit | This node matches the others | Config drift silently invalidates every comparison |
| Fixed position set, and its value | The rows can be tied to a place | A node logging from 0,0 measures nothing usable |
| Clock set | Rows can be lined up against the other nodes | Fall back to recording the start time by hand |
| Battery voltage, estimated hours | The node outlives the session | Swap the cell |
| **Which other nodes were heard in 30 s, and how strongly** | This node is actually in range | A link that is dead at drop-off is dead all day |

Then `READY`, the filename, and the display blanks.

**The last check only works for nodes placed after the first.** Node 1 hears nothing at its own drop-off because nothing else is on yet. Turn nodes on in placement order and walk back past the earlier ones, pressing the button to confirm they picked up their neighbours.

**A failed check does not stop the node.** It is shown, recorded in the `BOOT` row, and logging starts anyway. A node logging with a bad clock is worth far more than a node refusing to start; the analysis can be told about a known-bad field, but it cannot invent data that was never captured.

**The display is optional at runtime.** If it does not answer at startup the firmware notes it and carries on — a failed screen must never cost a session. The LED remains the running indicator regardless.

Non-negotiable for unattended use:

- **Flush often.** A field day that dies with forty minutes buffered in RAM is a wasted field day.
- **Date and time in the filename**, so a brownout-and-reboot creates a new file instead of overwriting the old one, and so a card full of sessions sorts itself. The boot counter still backs it up when the clock is unset, and still breaks ties inside a single minute.
- **On card failure, keep running.** Keep counting, signal on the LED, retry the mount. Do not halt — a node that stops logging is worse than one that logs a gap.
- **Nothing the self-test can do may be a one-time-only ability.** Every check it makes has to be re-makeable while the node runs (§9.4).

Power management: CPU at 80 MHz, both 2.4 GHz radios out of the picture. **No deep sleep** — the logger must continuously service the serial stream.

**The 2.4 GHz radios are absent, not idle.** The logger reaches the mesh radio over a serial pair and the card over SPI; WiFi and BLE take no part in any of it, and the module’s own ceramic antenna is left doing nothing. Neither was ever started — but "off because nothing asked" is a property of today’s code rather than a guarantee, and the first symptom of a library quietly bringing one up would be a current draw that no longer matches the battery arithmetic. The two are therefore held off in different ways, for a measured reason:

| | How it is kept off | Cost |
|---|---|---|
| **BLE** | `esp_bt_mem_release()` at boot, which is irreversible for the rest of the boot — nothing can start BLE afterwards | 6 bytes of flash |
| **WiFi** | Not touched in code at all. `check_radios.py` runs after every build and fails it if a WiFi or BLE entry point is linked into the image | none |

The asymmetry is deliberate. WiFi has no one-way release, and the only way to ask it to stop is to call into the WiFi stack — which links the whole stack in. Measured on this firmware, `esp_wifi_stop()` plus `esp_wifi_deinit()` cost **133 KB of flash and 16 KB of RAM** to switch off something that was never on, putting the entire radio stack inside the image in order to announce that the radio is unused. Checking the finished binary instead costs nothing and is the stronger claim: a radio whose start function is not present cannot be started. The check is proven by injecting a real `esp_wifi_stop()` call and confirming the build fails.

Per-node settings live in `firmware/src/config.h`: short name, pins, baud, flush thresholds, timings. It is the only file that differs between the four units — change the name, flash, label the box.

**Build with the `pioarduino` platform, not `espressif32`.** The official PlatformIO ESP32 platform still ships Arduino core 2.x, which has no ESP32-C6 support at all and fails outright with *"This board doesn't support arduino framework!"*. The community fork carries Arduino core 3.x and is what every C6 board needs today. It is pinned in `platformio.ini` for the same reason the library is.

The `BOOT` row records the self-test outcome alongside the configuration, so a file can be judged later without anyone having to remember what the screen said at the time.

### 9.2 Waiting for the clock

After the self-test, a node with no time **stops and waits before it logs anything.** The screen says what it wants:

```
N1 waiting for time
CONNECT YOUR PHONE
hold button to skip
logs anyway in 8:42
```

The LED blinks throughout, because a still screen and a dark LED for several minutes is indistinguishable from a node that has crashed.

**Holding the button for two seconds skips the wait** and logs undated. This is for the bench, where there is no mesh to hand over a time and sitting through the full timeout to test something else wastes ten minutes. It must be held rather than pressed, so that a knock in a bag cannot quietly cost a session its timestamps.

A node whose radio never answered skips the wait automatically — there is no point waiting for a time to arrive down a link that is not there. That is also what makes a bench test with no radio attached start immediately instead of hanging.

The deployment ritual this is built around: **switch a node on, connect your phone to any node on the mesh, walk away.** The phone hands its clock to the radio it connects to, that radio passes the time on to its neighbours, and each logger picks it up from the first packet it hears. The wait normally ends within seconds of the phone connecting, so its usual cost is nothing.

This is why the ritual matters: **a full power-down loses the time everywhere at once.** Neither the logger nor the radio has a battery-backed clock, so four nodes switched off on Tuesday and on again on Thursday all wake up blank together, with nobody left on the mesh to ask. Something outside the mesh has to reintroduce the time, and the phone in your pocket is the cheapest thing that can.

`CLOCK_WAIT_MS` in `config.h` sets the give-up bound — ten minutes by default, far longer than pairing a phone takes and short enough that nobody sits through it by accident. Set it to `0` to restore the older behaviour of logging immediately regardless, or to something enormous to refuse to log at all without a clock.

### 9.3 The menu

The summary page carries five state blocks in a fixed order — **C R P K H** — and the button walks through them in exactly that order, one page each. The menu is the home screen read one block at a time, not a second thing to learn.

| Press | Page | Block | Answers |
|---|---|---|---|
| — | Summary | all five | Can I walk away? |
| 1 | Card | **C** | Is it recording, and will the card last? |
| 2 | Radio | **R** | Is it set up like the other three? |
| 3 | Position | **P** | Can these rows be tied to a place? |
| 4 | Clock | **K** | Can this file be lined up against the others? |
| 5 | Heard | **H** | Who can it hear, and how well? |
| 6 | Power | *(battery)* | How much is left, and how busy has it been? |
| 7 | back to Summary | | |

Every detail page opens with **the same block, drawn by the same code as the summary row** — solid for passing, hollow with a slash for failing — in the top-left corner, ahead of the title:

```
[C] CARD                 1871 MB
--------------------------------
/LOG_N1_20260817_1432.csv
5218 rows written
```

Read left to right, that is the order the question is actually asked: which check this is, what it is called, and how it is doing. The block leads because it is the thing that was wrong on the summary row — you pressed through to find out about that mark, so it is what the page opens with. You press `P` because it looked wrong on the home screen, and the page you land on is still showing you `P`, still wrong, with the reason underneath.

Page 6 is the catch-all for everything with no block of its own: battery, uptime, packets heard and how long ago the last one was. The battery shape stands in the icon's place there, so the run of pages keeps its rhythm.

The first press wakes the screen wherever it was left rather than jumping home, so a second visit to the same node opens on what you were looking at last time.

### 9.4 Recovering without a power cycle

The self-test answers five questions once, while somebody is stood there. Every one of those answers can change afterwards — and the only way to act on a changed answer used to be to open the box and cycle the power, which throws away everything recorded so far. That trade is never worth making, so the running loop re-attempts each check on a timer.

The rule: **nothing the self-test can do may be a one-time-only ability.**

| Block | The fault that can clear | What the loop does about it |
|---|---|---|
| **C** Card | No card at switch-on; a card reseated, swapped, or that failed a write | Re-mount and re-prove writability, backing off 5 s → 30 s. Resumes the session's own file if it is still there; opens a new one, with its own `BOOT` row, if it is not |
| **R** Radio | Still booting; reset, brownout, connector shaken loose | Any word from the radio counts as proof of life. At 6 minutes of silence it is asked directly every 30 s; at 12 minutes it is treated as gone, and asked every 3 s until it answers |
| **P** Position | A coordinate set from a phone part-way through a session | Settings are re-read continuously; while no position is set the radio is also asked directly, every 60 s |
| **K** Clock | The first packet carrying a time arrives | Already recovered on its own; the file renames itself from its boot counter to its date |
| **H** Heard | A neighbour finally transmits | Already recovered on its own |

**The case that motivated this.** A node switched on with an empty slot could never start recording, however many cards were pushed in afterwards. The old retry path could only reattach to a filename that already existed, and with no card at boot there was never a file to reattach to — so the card was mounted, proven, and then ignored for the rest of the day.

**A radio that dies is worse than a radio that never starts.** The old check moved one way only, from "no answer" to "answered". A radio that reset mid-session went on reading `RADIO OK` on the screen while the node quietly recorded nothing for hours. Silence is now the evidence, and the window is deliberately longer than the gap between node reports — on a dead-quiet mesh those reports are the only thing proving the link is alive, so a shorter window would condemn a working radio every time.

**How long silence is allowed to run, and why it is twelve minutes rather than eight.** Surviving one dropped reply means surviving until the report *after* the one that went missing, which is two whole intervals, not one — so the window has to clear ten minutes before it can be trusted at all. Widening it does not slow detection, because the loop no longer waits the window out in silence: at the halfway mark the radio is asked directly, every 30 s, so a genuinely dead radio is challenged at six minutes and confirmed dead sooner than the old eight-minute window managed. What the wider window buys is that a single lost reply on a quiet mesh can no longer put a false `radio` fault, and a false recovery after it, into a file of real field data.

**Silence is timed from the end of the self-test, not from the radio's last word.** The boot sequence can spend up to ten minutes waiting for a phone to hand over the time, and it spends that wait listening rather than asking. On a mesh with nothing else on it, the radio's last word is the reply it gave in the first few seconds — so the first recovery tick would open on a radio that had been "silent" for longer than the window and declare a perfectly good radio dead. The clock starts when the node starts logging. A radio that never answered at all is still tracked separately, so it is never told its radio just died.

**A probe is only fired when a probe can actually help.** Asking the radio for a report does nothing about a card fault — the card retries on its own timer — so an empty slot no longer triggers serial traffic every 30 s for the rest of the day. Each condition now sets its own rate: a silent radio every 3 s, a quiet-but-not-condemned radio every 30 s, a missing position every 60 s, and a missing card not at all.

**Recovery is written down, not just performed.** Two audiences need different things and neither can reconstruct the other's:

- Rows formed while the card was down are **counted**, not buffered, and the count appears on every status row from then on as `drops=`. That number is the true size of the hole; a gap in the timestamps only says that *something* stopped.
- The moment a fault clears, a status row carries `recov=card`, or `recov=card+radio` when several clear at once.
- A file opened part-way through a session carries `resume=<seconds>` in its `BOOT` row, marking it as a continuation rather than a power cycle — which would otherwise look identical to a node that rebooted itself in the field.
- A recovery that happens while there is no card to write to is **held, not dropped**. A position arriving during a card outage changes what every row after it means, and the event fires exactly once; it is carried forward and written into the first status row of the file that eventually exists. Only the card's own return is skipped on a new file, because the `BOOT` row written a moment earlier already marks that instant.

`validate-csv` surfaces all three (`RESUMED`, `ROWS_DROPPED`, `RECOVERED`) as warnings rather than errors. A node that healed itself produced usable data; it just produced less of it than the session length suggests, and that has to reach whoever reads the card.

**Recovery probes are not written to the card.** While something is wrong the radio is asked for a node report far more often than the ordinary five minutes. With forty-odd nodes known to a radio, logging every one of those replies would bury the packet rows the session exists to collect — so probe replies update the node's own state and are otherwise discarded. The five-minute schedule that *does* reach the card is untouched.

**`rows=` counts the file it appears in.** A new file starts its row count at zero. Carrying the count over from the card that was pulled out would produce a number that cannot be reconciled against anything — the reader has one file, and the count would be describing two. `drops=` deliberately stays cumulative for the opposite reason: it measures what the *session* lost, and a session spans however many files it took.

**A node no longer counts itself as a neighbour.** Packets can arrive before the radio has said what this node's own number is, and until it does, the "is this me?" test has nothing to compare against — so this node's own transmissions were being counted as a neighbour, both in the live count on the screen and in the `st_heard=` figure written into the `BOOT` row, where nobody reading the card later could correct it. The count is cleaned the moment the number is known, in both places.

**One thing this fixed by accident.** The screen's single-word verdict was built from the boot snapshot while the state blocks underneath were read live. A node that lost its card mid-session therefore showed a red `C` block and the word `READY` at the same time. The verdict is now built from the same live state as the blocks, so the two can no longer disagree.

**What is still lost.** Everything heard while the card was unusable is gone — formed, counted, and discarded. Buffering those rows in RAM would close the gap for short outages and is noted in §15.

## 10. Generating traffic to measure

Range Test works as a traffic generator even though it cannot save:

```bash
meshtastic --port <PORT> \
  --set range_test.enabled true --set range_test.sender 60
```

`sender` is seconds between packets. Both sender and receiver need the module enabled.

**Airtime discipline.** Four nodes at one packet per minute on LONG_FAST is modest, but a hop limit of 3 means flooding multiplies packets on air. **Start at 60 s.** Going below 30 s without computing airtime will saturate the channel and you will measure congestion rather than path loss.

### 10.1 What the channel actually costs

The arithmetic, so the paragraph above is a computation rather than a habit. Time on air is the Semtech formula at a real Meshtastic packet — roughly 30 bytes with a 16-symbol preamble, not the 64-byte datasheet shape, which is about 40% longer:

| Preset | Config | Time on air |
|---|---|---|
| `LONG_FAST` | SF11, BW 250 kHz | **477 ms** |
| `MEDIUM_FAST` | SF9, BW 250 kHz | 130 ms |
| `SHORT_FAST` | SF7, BW 250 kHz | 40 ms |

Flooding is the multiplier that matters. Each node rebroadcasts a given packet at most once, so with a hop limit of 3 one originated packet becomes **between one and four transmissions** — one where nothing else can hear the sender, four where every node hears every other. Both ends of that range are live in a real deployment, because how much of the mesh each node can hear is exactly what a site decides — and it is rarely the same for every node in one run.

At `LONG_FAST`, per node, for the whole mesh:

| Sender interval | Originated per node | On air near a node | Channel busy |
|---|---|---|---|
| 60 s | 1 / min | 4 – 16 | **3.2 – 12.7%** |
| 30 s | 2 / min | 8 – 32 | 6.4 – 25.4% |
| 15 s | 4 / min | 16 – 64 | 12.7 – **50.9%** |

**Two consequences worth knowing before setting the interval.** Meshtastic holds back non-critical traffic once channel utilisation is high, and Range Test traffic is exactly the class it holds back — so past roughly a quarter of the channel the radios throttle themselves and the session measures the governor, not the path. And US 915 MHz carries no European-style duty-cycle ceiling, so nothing here is limited by regulation; the binding constraints are that governor and the channel itself.

**Do not take these as a substitute for measuring.** From schema v4 the radios report their own channel utilisation on every `NODE` row (§6.3) and `analyze-logs` prints it, so a session says what the load actually was rather than what this table predicted. Where the two disagree, the file is right.

**Target ≥100 received packets per directed link** for a stable median — per *link*, not per node. That distinction sets the length of the whole field day, and getting it wrong is how a session comes home a third short.

With four nodes each sending once a minute, a node hears about three packets a minute, but only **one per minute from any one sender**. Reaching 100 on every link therefore takes roughly **100 minutes of received packets, not 35** — and longer in practice, because only direct receptions (`hops_used == 0`) count toward a path measurement and some fraction of arrivals will have been relayed.

Plan on **two hours at 60 s intervals**. Shortening the interval shortens the session proportionally but loads the channel by the same factor, and below 30 s you are measuring congestion rather than path loss. Check progress on the card before packing up: `validate-csv --min-packets 100` reports the count on every link it saw.

## 11. Analysis

### 11.1 Direct versus relayed — the filter that matters most

```
hops_used = hop_start - hop_limit
```

**Only rows with `hops_used == 0` measure a direct RF path** between transmitter and receiver. Everything else measured the last relay's link. Build the link matrix from direct rows only; keep relayed rows for routing behaviour.

### 11.2 What the link cost, as opposed to whether it existed

`analyze-logs` prints a **CHANNEL LOAD** block beside the link table: median and peak utilisation per node, and each node's own share of transmit time. Read it before reading the link figures, because it decides what they mean.

A median in the low single digits means the links below were measured on a quiet channel and the numbers are about the path. A peak in the tens of percent means they were measured under congestion, and a weak link there may be a busy channel rather than a poor path — the two are indistinguishable from RSSI alone, which is the whole reason the column exists. The tool warns when peak utilisation crosses 25%.

Reports arriving with no metrics block are excluded rather than counted as zero, and the count of those is printed, so a node whose radio never reported cannot masquerade as a node on an idle channel.

### 11.3 Deduplication

Flood routing means the same packet ID arrives via multiple relays. Dedupe on `(tx_node, pkt_id, hops_used)` before counting anything.

### 11.3 Per-link metrics

For each ordered pair, direct rows only: packet count; RSSI median, 10th and 90th percentile; the same for SNR; distance from actual coordinates; elevation difference; and **asymmetry** between the two directions — real links are often several dB asymmetric.

Use **medians, not means.** RSSI distributions are skewed and a single multipath null wrecks a mean. Below ten samples the tenth and ninetieth percentiles are reported as the plain minimum and maximum, because interpolating a percentile from a handful of readings dresses up a range as a statistic.

Treat **+7 dB SNR as the practical reliable-link threshold**, not the theoretical −20 dB floor.

**On delivery ratio.** Nothing in these files records what was *transmitted* — only what arrived somewhere. So a true delivery rate is not recoverable, and `analyze-logs` reports instead the share of a sender's packets that reached anyone which also reached a given receiver directly. That is a useful comparison between receivers and a misleading one if read as an absolute.

`analyze-logs` does all of the above, refuses files the checker rejected, and reports nodes whose configuration differs from the rest — readings across differently-configured nodes are not comparable however clean the data looks.

### 11.4 Comparing antennas

Do not mix antenna models within a run. When comparing, **interleave A/B/A/B** rather than running all of A then all of B — weather, foliage moisture and channel conditions drift over hours, and a blocked design attributes that drift to the antenna. ≥100 packets per antenna per link, compared on medians.

## 12. Validation

Build **one** complete node and validate it end to end before assembling the other three. A wiring error found on unit one costs an hour; found on unit four it costs four.

**Confirmed on the first unit, 17 August 2026, firmware 0.4.1** — logger board only, radio not yet powered:

- Firmware builds, flashes and runs on the XIAO ESP32-C6.
- The card mounts and passes the write-and-read-back test. 1871 MB free reported on a 2 GB card.
- The OLED is found on the I²C bus and shows the self-test.
- The button wakes the running summary and the screen blanks again.
- The boot counter survives power cycles, so each boot opens its own file.
- With the radio absent the self-test reports it and the node **carries on into the loop rather than halting**, which is the degradation behaviour the whole design depends on.
- With the radio absent the clock gate (§9.2) is skipped rather than waiting out its timeout, so a bench test with no radio starts immediately.

**Confirmed on the first unit, 17 August 2026, firmware 0.5.0** — radio wired and powered, one complete node:

- The radio answers over `J7` at 38400 in `PROTO` mode. The screen shows the node number, `US`, `LONG_FAST` and hop limit 3, read back from the radio rather than assumed.
- The clock arrives from the radio and is correct to the minute, so the file is dated.
- Real packets from the surrounding mesh are received, counted per neighbour with RSSI, and written.
- Both power directions work: the radio's `VDD` runs the logger, and the logger's `3V3` runs the radio. **Only the first is the field configuration** — see the battery note below.

**Waiting for something you never asked for is not a timeout, it is a deadlock.** The first version of the boot self-test waited `RADIO_WAIT_MS` for `my_node_num` to become non-zero, having never sent a `want_config`. That value is only ever set by the reply to that request, and the library issues neither the request nor a retry on its own, so the check could not have passed on any node, ever — while packets still streamed in and the clock and neighbour checks went green, which made it read convincingly like a wiring fault. Two rules came out of it, and both are now in the code:

- **Ask before waiting**, and keep asking. Both boards share one supply and therefore boot together, so the first request usually lands on a radio that is still starting and is dropped in silence.
- **No check may latch at boot.** Card, radio, position, clock and neighbours are all re-read from live state on every screen refresh. A fault that has cleared but still shows red teaches people to stop believing the screen, which costs more than the original fault.

That second rule turned out to be half a rule. Re-*reading* live state keeps the screen honest, but it does not make anything come back — the check that failed has to be *re-attempted*, and until §9.4 none of them were. A node switched on without a card showed the fault correctly on the screen and then never recorded a row, no matter what anyone did short of a power cycle.

**The radio's battery percentage is only meaningful when the radio is the power source.** Back-fed from the logger's 3.3 V rail it reports that rail as a nearly-flat cell — 9% on the bench. The battery belongs on the radio's `P2` with the switch in its positive lead (§5.3), which is the same direction the field build uses anyway.

**First real capture, 17 August 2026 — 56 minutes, 421 rows, read back off the card and put through the checker and the analysis.** The format survived contact with the firmware, which is what writing the checker first was for. Three things came out of it:

- **A node logs its own transmissions.** The radio hands back everything it sends over the same serial link, with no RSSI and no SNR, and 37 of 82 packet rows were ours. Left in, they would have been averaged into the link statistics as perfect receptions at 0 dBm — more of them than there were real ones. The logger now drops any packet it originated, keeping only genuine receptions, and still takes the clock from them.
- **`channel` is not always a channel.** The protocol reuses that field to carry a channel *hash* whenever the payload is encrypted, which it says plainly in `mesh.proto`. A logger on a shared channel sees this constantly — 10 and 170 inside the first hour — and the checker was rejecting honest rows for it.
- **One MQTT packet condemned a clean fifty-six-minute file.** Traffic reaching the mesh through an internet gateway measures nothing about a radio path and the analysis drops it, but on any shared channel some will always arrive. It is a warning now. A checker that fails every real file is a checker people run with their eyes shut.

With those corrected the capture reduces to one warning, and the analysis produces its first real link: a node in the same room at **−28 dBm, +6.2 dB SNR, p10–p90 spread of 2 dB** over five packets.

**A card can pass on the logger and still be dead.** The first card mounted on the ESP32 and accepted a written row, while macOS could not mount it at all and could not read back a filesystem it had just written. The microcontroller's FAT implementation is far more forgiving than a desktop's. Prove a new card on a computer — write a large file, eject, read it back, compare — before trusting it with a session. The replacement was verified that way over 100 MB.

**The fixed position was the phone, not the radio.** With the iOS app's *Accurate Locations Only* setting on, every fix taken indoors — 10 to 65 m of accuracy — was rejected before it reached the radio, and the app then displayed *Fixed Position: on* regardless. The node looked configured and had no coordinate behind it, which is exactly the failure `st_pos` exists to catch. Turning the setting off produced a real coordinate on the next boot and all six checks green for the first time.

**The version numbers above are the logger's, not the radio's.** They are what `LOGGER_VERSION` in `config.h` said on the day, and they are what the `fw=` key in a `BOOT` row carries. Unit one's *radio* ran the vendor variant of 2.6.11 it shipped with for the early bench work, and was flashed to the pinned `v2.7.26` `rak4631` build (§8.1) on the same day; the successful position capture and everything after it were on 2.7.26. The radio's version is not recorded in the log rows at all — it lives only in that node's `--info` dump, which is why §8.4 asks for one per node per session and why a missing dump costs more than it looks.

**Measured draw, 39 mA average, is in §5.3** along with what it does to the battery and the box. The peak still needs taking again at a higher supply limit.

Still unproven on one node: steps 9 onward, including every recovery path in §9.4. Nothing involving four nodes has been attempted.

**The radio has to be configured before any of it means anything** — Meshtastic flashed, the Serial module enabled in `PROTO` mode at the right pins and baud, region set, fixed position written. This is what `tools/configure_node.py` is for, and it is **not written yet**; unit one was configured by hand with the §8 command. Doing it by hand once is fine for proving the link; doing it by hand four times is how three nodes end up differing from the fourth in a way nobody wrote down.

**Read the configuration back after writing it.** The radios ship with the Serial module disabled and its pins unassigned, and a node in that state still joins the mesh, still relays, still looks healthy from a phone — it simply never speaks to its logger. `meshtastic --info` is the only thing that distinguishes it from a working node.

1. Continuity and short checks with everything unpowered — 3.3 V to ground must read open.
2. First power-up on the current-limited bench supply.
3. Prove the PROTO stream exists using a 3.3 V USB-serial adapter and `meshtastic --listen`, with no logger board involved. The pin numbers come from the board revision (§8) rather than from trial. If PROTO refuses but NMEA produces readable sentences on the same wiring, the wiring is fine and the problem is protocol-side.
4. Verify whether the CLI pushes device time.
5. Unmodified library, two boards on a desk — proves handshake, heartbeat and framing before touching library internals.
6. Forked library, RSSI and SNR printed to the console. From across a room expect −30 to −60 dBm and +5 to +12 dB.
7. Add card writing. Power-cycle mid-write repeatedly; confirm no corruption and a fresh file per boot.
8. Add the display and the boot self-test. Prove each check **fails** as designed, not just that it passes: pull the card, unplug the radio's serial line, clear the fixed position, and confirm the screen says so and the node still starts logging. A self-test that only ever shows green has not been tested.
9. Prove each check **recovers**, which is the other half of step 8 and the one that decides whether a box can be left alone (§9.4). Six separate runs, no power cycle in any of them:
    - Switch on with an empty slot, wait a minute, push a card in. A new file must appear within thirty seconds, carrying its own `BOOT` row with `resume=` on it and `st_card=1`. Run `validate-csv` on it: `RESUMED` and `ROWS_DROPPED` as warnings, no errors.
    - Pull the card mid-session and put the **same** card back. The node must resume the same file — one `BOOT` row in it, not two — and the next status row must carry `recov=card` and a non-zero `drops=`. Confirm `rows=` in that status row counts only what this file holds.
    - Pull the card mid-session and put a **different** card in. A new file, again with its own `BOOT` row, and its first status row must show `rows=` restarted from zero rather than continuing the previous card's count.
    - Unplug the radio's serial line for fifteen minutes and reconnect it. The screen's `R` block and its verdict must both go bad, and both must come back; a status row must carry `recov=radio`. Fifteen minutes because the silence window is twelve — anything shorter proves nothing. Watch the console: probing must start at the six-minute mark, well before the block goes red.
    - Boot a node on a mesh with nothing else transmitting and let the clock wait run its full ten minutes, then let it log for twenty. The `R` block must stay green throughout and no `recov=radio` may ever appear — a false radio fault here is exactly what this window was widened to prevent.
    - Pull the card, then set the fixed position from a phone **while the slot is empty**, then push the card back. The first status row of the new file must carry `recov=pos` — the position change must not be lost just because there was nowhere to write it at the moment it happened.
10. Fit the switch and the button. Confirm the node survives fifty power cycles, that a press wakes the display and it blanks again, and that the button does nothing harmful if held down at power-up.
11. Measure actual current draw and replace the estimates in §5.3. **The average is done — 39 mA** — so what remains is the peak at a **500 mA** supply limit rather than the 200 mA one that clipped it, and a second reading with the display lit, so the cost of the screen is a number rather than an assumption.
12. Four nodes on a desk for two hours, antennas attached, real traffic intervals. Confirm every node saw every other and counts are roughly symmetric — `validate-csv --min-packets 100` answers both, and must report no errors.

    Do the **frequency-slot survey first** (§8.5), because it decides what the rest of the runs are measured on: one node on the candidate slot, half an hour, then read the card. Foreign nodes in that file mean the slot is occupied and another must be chosen. Only once a slot is proven clear are all four moved onto it, and from that point every node in the set carries identical `lora.channel_num`, `device.rebroadcast_mode` and `lora.hop_limit` — verified by a fresh `--info` connection per §8.3, not by the value the write echoed back.
13. One node on battery until it dies. **Multiply the planned session by 1.5 and confirm the battery beats it.**
14. Sealed enclosure, 300 m walk and back. Confirm sensible signal roll-off with distance, and that the switch and button are usable through the enclosure with cold hands.

A 3.3 V USB-serial adapter is required. **A 5 V logic adapter will damage the nRF52840.**

## 13. Repository layout

```
firmware/                 PlatformIO project for the logger board
  platformio.ini
  src/
    config.h              per-node settings; the only file that varies
    log_schema.h          the CSV contract, mirroring the Python schema
    clock.*               absolute time, the timezone rule, the file stamp
    logfile.*             card, boot counter, rows, flushing, remounting
    recovery.*            re-attempting every failed check while the node runs
    screen.*              the OLED; optional at runtime
    selftest.*            the boot checks and how they are shown
    main.cpp              callbacks and the loop
tools/                    Python, uv-managed
  src/fieldlab/
    schema.py             the file format; single source of truth
    validate.py           the checker; written before the firmware
    analyze.py            dedupe, direct-only filter, per-link metrics
    synth.py              a whole synthetic session, for building the analysis
    cli.py                validate-csv, analyze-logs, synth-log
    configure_node.py     applies radio config, saves --info dump
    dem_lookup.py         lat/lon -> ground elevation
  tests/
config/                   per-node --info dumps, redacted (§8) — raw ones are gitignored
data/                     field logs (data/raw is gitignored)
docs/
```

## 14. Licensing

This repository is **GPL-3.0**, because it builds on `Meshtastic-arduino`, which is GPL-3.0. That was already true of the Python tooling for the same reason.

The forked library remains GPL-3.0 and is referenced, not copied — see §4.2. Its licence is recorded in the dependency table in the README, as every dependency here is.

## 15. Open items

Determined only with hardware in hand:

1. ~~Whether this RAK19003 revision maps `J7` to 16/15 or 20/19~~ — **resolved by the board revision, see §8.** The boards in hand are Rev E, so 19/20
2. Whether the CLI pushes device time on connect
3. Whether these microSD modules need added pull-ups on this bus
4. ~~Real per-node current draw~~ — **average resolved: 39 mA on a complete node, §5.3.** Two parts still open: the peak, which must be re-taken at a 500 mA supply limit because 169 mA was read against a 200 mA one, and idle draw with the screen lit rather than blanked
5. Which antenna model shipped with the radio kits, for the baseline record
6. The OLED's I²C address — `0x3C` on most of these modules, `0x3D` on some. Scan the bus on the first unit and record it; a wrong address looks exactly like a dead screen
7. Whether the OLED module's regulator is happy at 3.3 V — many are sold as "3.3–5 V" but a few assume 5 V and are dim or dead on a 3.3 V rail. There is no 5 V rail here
8. Whether altitude survives the trip. `Meshtastic-arduino` narrows the protocol's 32-bit altitude to a **signed byte** in its node struct, so anything outside ±127 m is already lost before the logger sees it. Fine for the sites in mind, but it is a third field the library quietly damages, and it would need the same treatment as the other two if a taller site is ever used

9. **The radio's firmware version is not recorded in the log.** `fw=` in a `BOOT` row is the logger's version; the radio's is pinned in §8.1 and captured only in the per-node `--info` dump. A session whose dump goes missing therefore cannot prove which firmware measured it. Adding a `rfw=` key to the `BOOT` row would close this — an optional key, so it costs no schema version (§6.1) — but the logger would have to learn the radio's version first, and nothing currently asks the radio for it

10. **Whether the radio's two headers land on the 2.54 mm grid.** `J6` and `J7` are both 2.54 mm pitch, but the distance between them decides whether the base board drops straight into a proto board or sits on standoffs with five short wires instead (§5.5). It changes the assembly method, not the layout
11. **The assembled height of the radio stack.** It is the tallest thing in the node and the only thing that sets the lid, so the enclosure height in §5.6 stays provisional until it is measured on a seated core
12. **The cell's actual dimensions.** §5.6 assumes roughly 50 × 34 × 6 mm. A thicker cell of the same footprint costs box height and nothing else

Each is written so it is a one-line change, not a rewrite.

Deliberately not built yet:

9. **Buffering rows through a card outage.** Recovery (§9.4) restores logging without a power cycle, but everything heard while the card was unusable is still counted and discarded. A few hundred packets held in RAM — well within the ~300 KB spare — would close the gap for a card reseated by hand, which is the common case. It is not built because the retry loop had to exist first: without it the buffer would have had nowhere to drain to.

## 16. References

- [Serial module configuration](https://meshtastic.org/docs/configuration/module/serial/)
- [Client API and PROTO framing](https://meshtastic.org/docs/development/device/client-api/)
- [Range Test module](https://meshtastic.org/docs/configuration/module/range-test/)
- [RAK19003 datasheet](https://docs.rakwireless.com/product-categories/wisblock/rak19003/datasheet/)
- [XIAO ESP32-C6 pin multiplexing](https://wiki.seeedstudio.com/xiao_pin_multiplexing_esp32c6/)
- [Meshtastic-arduino](https://github.com/meshtastic/Meshtastic-arduino)
- [PROTO-over-serial troubleshooting](https://github.com/orgs/meshtastic/discussions/253)
- [USGS 3D Elevation Program](https://www.usgs.gov/3d-elevation-program)
