offgridevices/mesh-fieldlab/(commit log)

2026-08-10 Document scope, licensing, and provenance guards
    Set out what this repository is for, what belongs in it, and what does not.
    License as GPL-3.0 to match the Meshtastic Python dependency: a Python
    import of a GPL-3.0 library creates a derivative work, so inheriting the
    license is the honest reading rather than a default.
    Add .gitignore rules that block third-party source, local working notes,
    and raw field captures from being staged by accident. License obligations
    travel with code, so external project clones are kept outside this tree
    entirely; the ignore rules are a second line of defence.
2026-08-11 Document the packet logger design; correct hardware and ignore rules
    Adds docs/packet-logger-design.md: why a Meshtastic radio cannot log
    received-packet metadata to a card by itself on nRF52 hardware, and the
    design of a small companion logger that can. Covers the architecture,
    the Meshtastic-arduino change it needs and how that is delivered as a
    pinned fork rather than vendored source, the CSV contract between logger
    and analysis, firmware behaviour under unattended operation, radio
    configuration, and the bench validation sequence.
    Corrects the README hardware section: the logger is a XIAO ESP32-C6 on
    the node's UART header, not the Raspberry Pi Zero previously described.
    Records Meshtast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
2026-08-16 Pin the log file format and add its checker
    Settles the CSV the logger writes before any firmware depends on it, and
    adds the tool that enforces it. schema.py is the single source of truth;
    validate-csv reads through it, and a test fails if the header there ever
    diverges from the one documented in docs/packet-logger-design.md.
    The checker sorts problems into two kinds. An error means the file cannot
    be trusted: a wrong header, a node apparently receiving its own
    transmission, hop counts that contradict each other, packets that arrived
    over MQTT rather than the air, a fixed position left at 0,0, a non-finite
    signal reading that would otherwise sail past every range check. A warning
    means the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
2026-08-16 Pin the forked library now that the packet-metadata change exists
    Records the exact commit the firmware will build against, replacing the
    placeholder. The change adds a callback carrying each packet's reception
    metadata — signal strength, signal-to-noise ratio, hop counts, routing
    hints — which upstream decodes and then discards before any caller can see
    it. It fires for every packet, including those whose port number is
    unrecognised and those whose payload cannot be decrypted, since both still
    carry a signal reading and a receiver counting what reached it must not
    miss them.
    It ships with an example sketch and a host-side test suite that builds the
    library against a stub Arduino layer,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
2026-08-16 Add a power switch, a status display, and a boot self-test
    Each node gains a switch in the battery lead and a small OLED that runs a
    check at power-up: the card mounts, a row is written and read back, the
    radio answers, its region and preset and hop limit match the others, a
    fixed position and a clock are set, the battery will outlast the session,
    and which neighbours were audible during a thirty-second listen. Then the
    screen blanks. A push button wakes it for ten seconds.
    That last check is the point of the whole thing. A link that is dead at
    drop-off is dead all day, and until now there was no way to know without
    bringing a phone to every node.
    The display is on I2C rather than SPI, del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
2026-08-16 Add the logger firmware
    Everything it depends on now exists, so this is the program that runs on the
    board: read each packet the radio reports, write a row, flush often, and keep
    going through anything a person is not present to fix.
    At power-up it runs a self-test somebody can read while standing over it. The
    card is mounted and then proved writable by writing a row, flushing it and
    reading it back, because a card that mounts but silently discards writes looks
    healthy for hours. The radio is given fifteen seconds to answer, which proves
    wiring, baud rate and PROTO mode at once. Its region, preset and hop limit are
    read back off it, which is the only way to catch config drift between nodes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
    [config.h, log_schema.h, logfile.cpp, logfile.h, main.cpp, screen.cpp, screen.h]
2026-08-16 Add the analysis, and make the generator model one shared mesh
    analyze-logs reduces a session to its links. Four nodes make six pairs and
    each pair is two directed links, because radio paths are not symmetric, so
    the output is those twelve numbers and how much confidence each deserves.
    Three decisions do most of the work, and getting any of them wrong produces
    a result that looks reasonable and means nothing. Only direct receptions
    measure a path — a relayed packet describes its last hop, not the pair of
    nodes at its ends. Flood copies are removed before anything is counted, or
    every figure inflates in proportion to how well the mesh was working. And
    every figure is a median, because one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
2026-08-16 Resolve the UART pin question from the board revision, and pin down the wiring
    The design carried an open item: whether this base board maps the serial
    header to pins 16/15 or 20/19, to be settled by trying one and then the
    other. It is settled by reading the silkscreen instead.
    RAK moved which UART reaches J7 at revision D. Rev B exposes UART1 there
    and silkscreens RX1/TX1; Rev D and later expose UART0 and silkscreen
    RX0/TX0. The datasheet was never updated and still shows the Rev B
    arrangement, which is why the question looked ambiguous. The wiring is
    identical either way — only serial.rxd and serial.txd change. The boards in
    hand are Rev E, so the configuration example now reads 19/20.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
2026-08-16 Record how to run a node from a bench supply instead of a cell
    A bench supply on the battery connector is not a compromise, it is the
    better way to work up to the first field day: the current limit turns a
    wiring mistake into a number on a display rather than a smell.
    Adds the constraints that make it safe. Stay inside the cell's range, 3.8
    to 4.0 V — above 4.3 V damages the board, and 3.3 V is low enough that the
    regulator drops out under load. Raise the limit to 500 mA once the radio
    transmits, because 130 mA bursts against a 200 mA limit brown the node out
    and present as random resets rather than as a supply problem.
    Also records two things that are easy to get wrong. Running USB and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
2026-08-16 Write down how to format the card and install the build tool
    Two things that were assumed knowledge and are not.
    The card must be FAT32 with an MBR partition scheme. exFAT does not work
    with the Arduino SD library at all, and a GUID scheme frequently fails to
    mount, so "format it on a Mac" without qualification produces a card that
    looks fine and does not work. Records the exact Disk Utility path,
    including selecting the device rather than the volume, which is where that
    setting hides. The card is left empty — the firmware creates its own file.
    Installing PlatformIO with `uv tool install` fails in a way that is hard to
    read: the tool environment has no pip, and PlatformIO shells out to p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
2026-08-16 Echo the boot self-test and packets to USB serial
    Flashed the first board and found the firmware silent: Serial.begin was
    called and nothing ever printed. With no display attached yet — which is
    exactly the state a first board is in — bringing a node up meant fifteen
    seconds of nothing followed by no indication of what had been found.
    Everything the screen shows now also goes to the console, plus a line per
    received packet with its signal strength, hop status and whether it
    arrived over the air. The two are independent: a node with no display and
    no USB still logs correctly, and a fault in either is visible through the
    other.
    Where a check fails the console says what to look at rather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
    [config.h, main.cpp, selftest.cpp]
2026-08-16 Record the first unit's bench results
    The logger half of a node now works on real hardware. The firmware builds,
    flashes and runs; the card mounts and passes the write-and-read-back test
    at 939 MB free; the display is found on the I2C bus and shows the
    self-test; the button wakes the running summary and the screen blanks
    again.
    The result worth keeping is the last one. With the radio absent the
    self-test reports it and the node carries on into the loop rather than
    halting. That is the degradation behaviour the whole design rests on, and
    it is now observed rather than intended.
    Everything involving the radio remains unproven.
2026-08-16 Redesign the screen as a five-page menu you can read at a glance
    The old screen was four dense lines that had to be read word by word to
    learn one thing. The question somebody actually has, standing over a node
    about to walk away, is "can I walk away" — and that should be answerable
    without reading.
    The summary page now says one word in large type, and underneath it a row
    of five blocks, one per check, in a fixed order. A passing check is a solid
    block, so all-good is an even rhythm and any failure is a hole in it, which
    the eye catches before it has read a character. A failed block also carries
    a slash so it cannot be mistaken for a smudge. The battery is a shape
    rather than a number for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
    [main.cpp, screen.cpp, screen.h, selftest.cpp, selftest.h]
2026-08-17 Name log files by date and time, not boot count
    One file per power cycle, stamped with the local date and time logging
    started: LOG_<NAME>_<YYYYMMDD>_<HHMM>.csv. A card full of sessions now
    sorts itself, no file grows without bound, and a node switched off and
    on days later produces a file that says so on the outside.
    Rows keep UTC. People get local time on the name, machines get UTC
    inside, so no analysis has to reason about which side of a daylight
    saving change a session landed on. The BOOT row now carries tz and
    utcoff, which is what maps the name back to UTC later.
    Add a clock module as the single owner of absolute time. It installs a
    POSIX timezone rule, so the offset stays right yea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
2026-08-17 Hold the boot until the clock is set before logging anything
    A file that starts before the time is known cannot be lined up against
    the other three nodes, and the rows written in that window would be the
    only ones in the session carrying no absolute time. So the boot now
    stops after the self-test and waits, with the screen naming the action
    rather than the fault: connect your phone to any node on the mesh.
    The wait is bounded, not absolute. Ten minutes by default, far longer
    than pairing a phone takes and short enough that nobody sits through it
    by accident. It ends the instant a packet arrives carrying the time, so
    its usual cost is nothing. If it does expire the node logs anyway under
    the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
    [config.h, selftest.cpp, selftest.h]
2026-08-17 Make the menu follow the summary row, one block per page
    The pages were a list somebody had to learn: activity, neighbours,
    radio, card. The summary row was C R P K H. Nothing connected the two,
    so seeing a hole in the row told you a check had failed but not which
    button press would explain it.
    The button now walks the blocks in the order they are drawn. Press once
    for C and get the card, again for R and get the radio, then P, K, H, and
    finally the one page with no block of its own -- battery, uptime,
    packets, and how long ago the last one landed. Then back to the summary.
    Every detail page carries its own block in the top-right corner, drawn
    by the same routine as the summary row rather t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
    [clock.cpp, clock.h, config.h, main.cpp, screen.cpp, screen.h]
2026-08-17 Lead each detail page with its block, not end with it
    The block sat in the top-right corner, after the title. Read left to
    right that put the answer before the question: you saw "CARD" and had
    to travel to the far edge to find out whether the card was any good.
    It now leads:
    [C] CARD 1871 MB
    --------------------------------
    /LOG_N1_20260817_1432.csv
    5218 rows written
    Which check this is, what it is called, how it is doing. The block goes
    first because it is the mark that was wrong on the summary row, and
    that mark is why anyone pressed through to this page at all.
    The power page has no block of its own, so the battery shape stands in
    the icon's place and t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
    [config.h, screen.cpp]
2026-08-17 Record the first unit's second bench pass, and the dead card
    Updates section 12 with what firmware 0.4.1 actually proved on the
    bench: the card mounts and passes write-and-read-back with 1871 MB
    free, the boot counter survives power cycles, and with no radio present
    the clock gate is skipped rather than waiting out its ten minutes.
    Also records a finding worth more than the pass itself. The first card
    mounted on the ESP32 and accepted a written row while macOS could not
    mount it at all, and could not read back a filesystem it had just
    finished writing. A microcontroller's FAT implementation is far more
    forgiving than a desktop's, so "the logger wrote to it" is not evidence
    a card is sound.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
2026-08-17 Ask the radio who it is before waiting for the answer
    The boot self-test waited for my_node_num to become non-zero without ever
    sending the request that sets it. The library issues neither that request
    nor a retry on its own, so the radio check could not have passed on any
    node, ever. Packets still streamed in, so the clock and neighbour checks
    went green and the whole thing read like a wiring fault.
    Ask first, and keep asking every three seconds: both boards share one
    supply and boot together, so the first request lands on a radio that has
    not finished starting and is dropped in silence. Wait forty-five seconds
    rather than fifteen, which only runs to the end when there is genuinely
    no radi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
    [config.h, main.cpp, selftest.cpp, selftest.h]
2026-08-17 Do not let the screen claim a position the radio does not have
    The position check read the fixed-position setting, which says only that the
    radio has been told to keep a position — not that it has one. Meshtastic's
    flag freezes an existing coordinate rather than creating one, so a node that
    never held a position shows the setting on, the app agrees, and the node
    records a whole session of rows that can never be placed on a map.
    Require a coordinate behind the flag. Zero is treated as absent.
    The settings were also read once, two seconds after the radio answered, and
    never again. They arrive as a series of blocks and the position block lands
    after that, so the value being tested was the z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
    [config.h, main.cpp, selftest.cpp, selftest.h]
2026-08-17 Let a node fix itself without being switched off and on
    The boot self-test answers five questions once, while somebody is stood
    there watching, and until now none of those answers could change back.
    A node switched on with an empty slot could never start recording,
    however many cards were pushed in afterwards: the retry path could only
    reattach to a filename that already existed, and with no card at boot
    there was never a file to reattach to. The card was mounted, proven, and
    then ignored for the rest of the day.
    Acting on any of it meant opening the box and cycling the power, which
    throws away everything recorded so far. That trade is never worth
    making, so the running loop now re-attempts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
    [config.h, logfile.cpp, logfile.h, main.cpp, recovery.cpp, recovery.h, selftest.cpp]
2026-08-18 Stop the recovery layer condemning a radio that is working
    Three faults in how silence is measured, all of which put a warning on
    real field data that nothing was wrong with.
    The silence clock started from whenever the radio last happened to
    speak, not from when logging began. A boot can spend ten minutes
    waiting for a phone to hand over the time, and it spends that wait
    listening rather than asking — so on a mesh with nothing else on it the
    radio's last word is the reply it gave in the first few seconds, and by
    the time the first check runs it has been quiet for longer than the
    window allows. The very first check would declare a perfectly good
    radio dead. The clock now starts when the no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
    [config.h, recovery.cpp]
2026-08-18 Stop the card and the neighbour count reporting things that did not happen
    Three more faults, these ones about what gets written down rather than
    what gets asked.
    A recovery that happened while there was no card to write to was
    announced on the console and then lost. That is the worst possible
    moment for it: a position set from a phone during a card outage changes
    what every row after it means, and the event fires exactly once. It is
    now held and written into the first status row of the file that
    eventually exists. Only the card's own return is still skipped on a
    brand-new file, because the row written a moment earlier already marks
    that instant.
    The row counter carried over between files.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
    [logfile.cpp, main.cpp, selftest.cpp]
2026-08-18 Write down why a private channel does not close a test mesh
    A controlled test of a fixed set of nodes only measures what it claims
    to if the set is actually closed, and the obvious way to close it does
    not work. The setting is named in a way that invites exactly the wrong
    conclusion, so the reasoning is recorded rather than left to be
    rediscovered.
    A channel is a name and a key layered on top of the radio mesh. It
    decides who can read a packet. It does not decide who hears one, and it
    does not decide who relays one — the project's own documentation is
    explicit that nodes rebroadcast all packets sharing their modem
    settings irrespective of encryption, and that every node in the radio
    mesh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
2026-08-19 Write down how the node is physically built, not just wired
    The hardware section described every wire and no geometry. It named the
    parts and said what connected to what, then stopped — leaving the
    question of where any of it sits, and what encloses it, as something
    that would have to be worked out again by whoever built the second
    unit. Two new subsections close that.
    Everything in them follows from one measurement. The base board is
    30 mm wide, and on a 50 mm proto board that leaves room for exactly one
    more module beside it, and only if that module is the narrow one. That
    chooses the board, chooses its orientation, and therefore chooses which
    wall every opening in the enclosure has to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
2026-08-19 Make the 2.4 GHz radios provably absent, not merely unused
    The design document claimed the logger ran with WiFi and Bluetooth off. That
    was true in effect and unsupported in fact: nothing in the firmware ever
    started either one, so both stayed down, but nothing prevented them coming up
    either. "Off because nobody asked" survives exactly as long as nobody adds a
    library that asks, and the first symptom would have been a current draw that
    no longer matched the battery arithmetic the session length rests on.
    Turning them off at boot is the obvious fix and is only half right, which the
    measurements made clear. Releasing the Bluetooth controller's memory is
    irreversible for the rest of the boot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
    [check_radios.py, config.h, main.cpp]
2026-08-26 chore: ignore .vscode/ so editor settings stay personal
    The template had this line commented out. Enabling it, with a note on why.
    Workspace settings are not only formatting preferences: keys such as
    chat.agentSkillsLocations designate folders as sources of agent skills, the
    instruction files an AI assistant loads and follows. Committing those makes
    repo content able to steer every contributor's assistant with no explicit
    opt-in, and .github/ in particular gets read as CI config rather than as
    instructions.
    Follows the revert of 95d60cb, which removed exactly such a file. No .vscode
    file is tracked, so nothing is dropped by this - and `git add -f` still works
    if a specific one is ever genu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
2026-08-26 ci: Claude code review on pull requests
    First workflow in this repo. Structure follows the ones already running in
    cairn and OffGrid-Devices, including the same pinned action commits, so all
    three behave the same way and get updated deliberately rather than by a
    mutable tag moving under us.
    Repo-specific review priorities, in the prompt:
    1. the CSV schema is the product - the firmware writes the log and the
    Python tooling validates it, so the two must agree exactly, and nothing
    may make previously valid logs fail to parse
    2. measurement correctness - wrong RSSI, SNR, timestamps or derived figures
    are worse than a crash, because they produce plausible data nobody
    noti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
2026-08-26 Point at the hardware repo, and make the pin map checkable
    The boards now live in offgridevices/offgrid-hardware under CERN-OHL-S, so
    this repository keeps a signpost rather than a copy.
    hardware/README.md says where the carrier went and why: this repository is
    GPL-3.0, inherited from the Meshtastic libraries the firmware and tooling
    depend on, and that licence's language - source code, object code,
    installation information - does not map onto Gerbers and drill files.
    CERN-OHL-S is written for hardware and carries the same reciprocal intent.
    One licence per repository is honest; a per-directory split is not.
    The real cost of splitting them is that the firmware drives pins the board
    defines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
2026-08-26 Stop the generator writing files its own checker rejects
    Two bugs, both reachable from ordinary settings, both found by widening one
    test that had only ever run the defaults.
    chan_util and air_tx carried unbounded Gaussian noise. The default config sits
    far enough above zero that the noise can never reach it, but the offered load
    falls with fewer nodes and a longer interval, and the figures go negative -
    which validate-csv rejects as EXTRA_RANGE, because schema.py requires both in
    0..100. Two nodes on a five minute interval failed every file it wrote, and a
    three node mesh on two minutes failed most of them. Clamped, for the same
    reason emit already clamps RSSI rather than trusting the mode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
2026-09-24 ci: add CI, gate Claude review on it, Opus 5.5 medium, Blacksmith 2 vCPU
    - New ci.yml (push to main + workflow_call): `tools` runs the Python test
    suite (uv, 167 tests incl. the pin-map contract); `firmware` compiles
    with PlatformIO, which also runs the no-WiFi/BLE post-build check.
    Nothing that needs a board.
    - claude-code-review.yml calls ci.yml first; review has `needs: ci`, so a
    red suite stops the PR with no paid review. Fork PRs now excluded
    (public repo). ubuntu-latest -> blacksmith-2vcpu-ubuntu-2404.
    - Review: --model claude-opus-5-5 --effort medium; sandbox with tools and
    PlatformIO installed, Write/Edit for throwaway probe tests; checks the PR
    description against the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
2026-09-24 ci: pin setup-uv to v10.2.0 (no floating v10 tag exists)
    Claude-Session: https://claude.ai/code/session_01Gny8cvuoF4hCscVBVhUzAm
